MattiasVLar/AmpouleIntelligente/EDA/3DEL_MCPCB/DEL_MCPCB/DEL_MCPCB.step

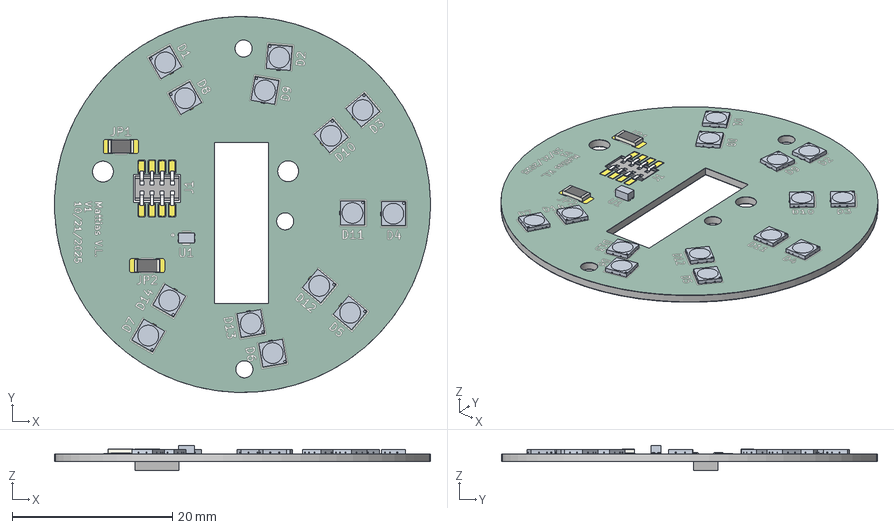
[picture p1: CAD file, 2025-12-03]
EDA/3DEL_MCPCB/DEL_MCPCB/DEL_MCPCB.step
47.0 x 47.0 x 3.16 mm
CLP-104-2-L-DTRM
C-106-22-1-L-04_Pin x 2
3030-14-H1 EMC UNIT SIZE x 14
3030-14-H1 LF UNIT SZIE x 14
ӫ¹⽺ x 14
R_1206_3216Metric x 2
80216oplga4l
DEL_MCPCB_copper
DEL_MCPCB_silkscreen
DEL_MCPCB_soldermask
DEL_MCPCB_PCB
