MattiasVLar/AmpouleIntelligente/EDA/Includes/3D/FTSH-104-01-L-DH.step

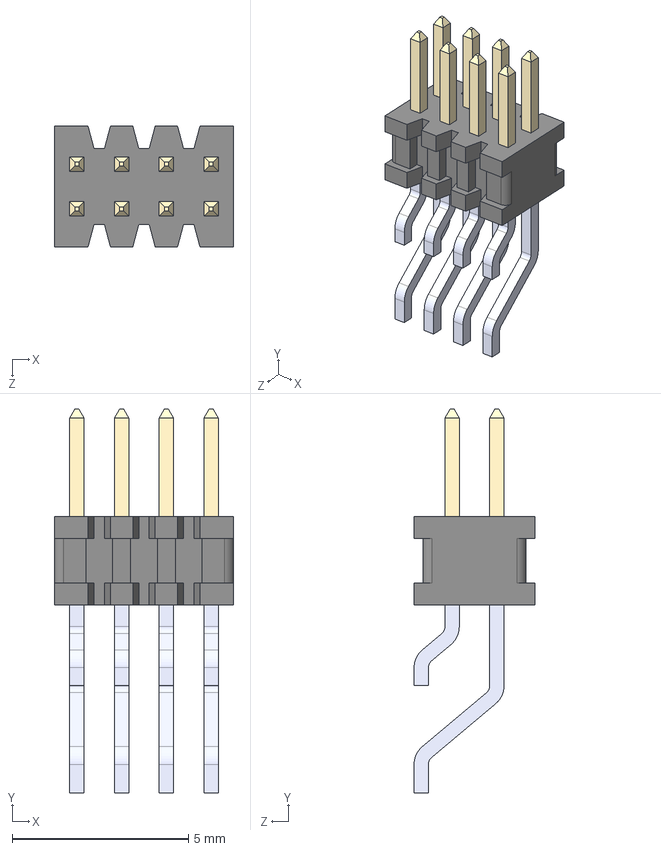
[picture p2: CAD file, 2025-12-03]
EDA/Includes/3D/FTSH-104-01-L-DH.step
5.08 x 10.9 x 3.43 mm
