MattiasVLar/AmpouleIntelligente/EDA/Includes/Downloads/1N5819HW_7_F/1N5819HW-7-F.step

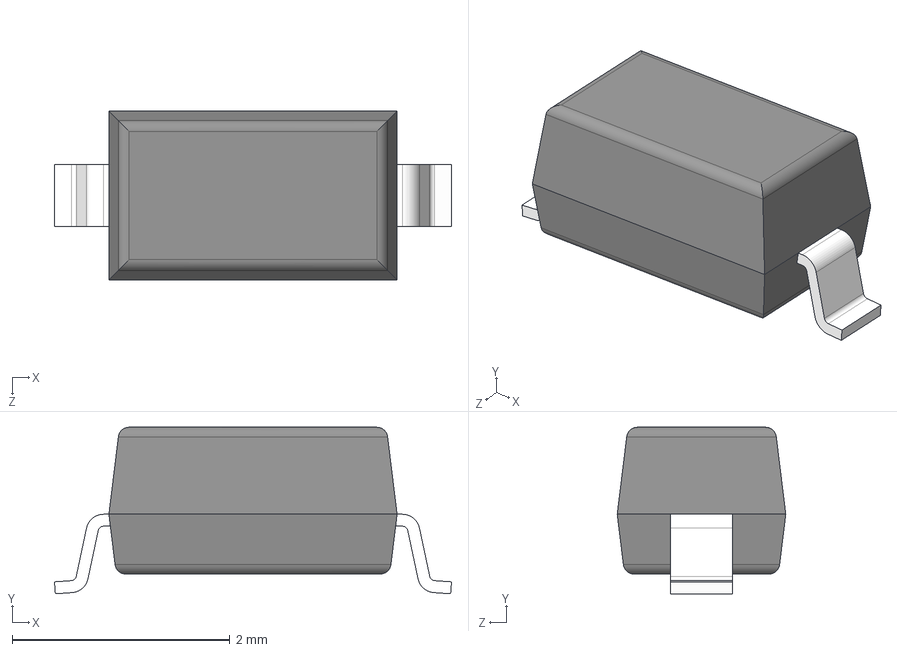
[picture p3: CAD file, 2025-12-03]
EDA/Includes/Downloads/1N5819HW_7_F/1N5819HW-7-F.step
3.65 x 1.53 x 1.55 mm
