MattiasVLar/AmpouleIntelligente/EDA/Includes/Downloads/35ZLH470MEFC10X16/CAP_YX_10X16_RUB.step

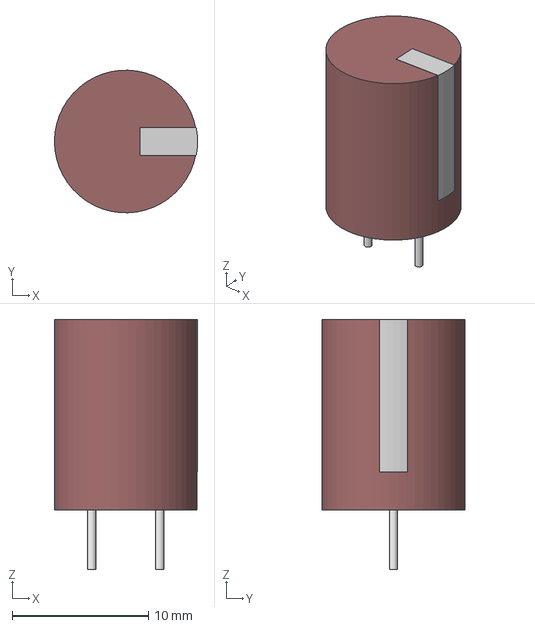
[picture p4: CAD file, 2025-12-03]
EDA/Includes/Downloads/35ZLH470MEFC10X16/CAP_YX_10X16_RUB.step
10.5 x 10.5 x 18.4 mm
