MattiasVLar/AmpouleIntelligente/EDA/Includes/Downloads/400AX15MEFC10X16/CAP_AX_10X16_RUB.step

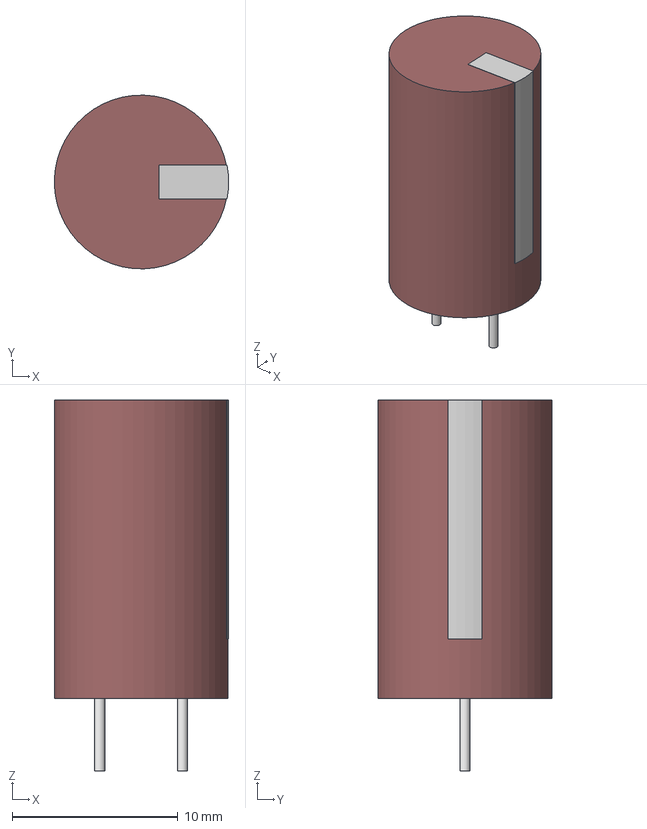
[picture p5: CAD file, 2025-12-03]
EDA/Includes/Downloads/400AX15MEFC10X16/CAP_AX_10X16_RUB.step
10.5 x 10.5 x 22.4 mm
