MattiasVLar/AmpouleIntelligente/EDA/Includes/Downloads/450BXW15MEFR10X20/450BXW15MEFR10X20.step

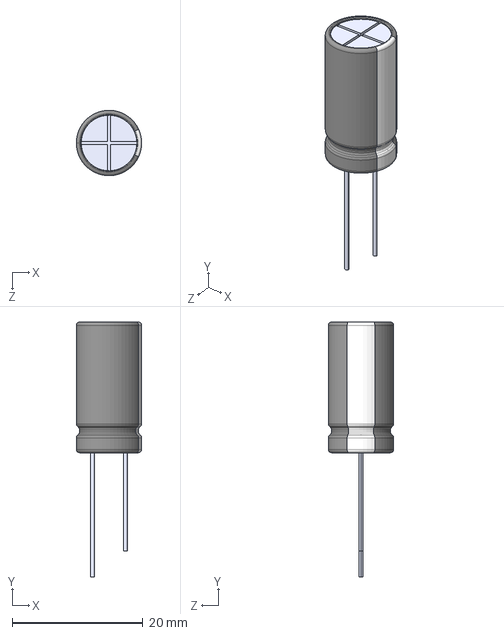
[picture p6: CAD file, 2025-12-03]
EDA/Includes/Downloads/450BXW15MEFR10X20/450BXW15MEFR10X20.step
10.00 x 39.0 x 10.00 mm
