MattiasVLar/AmpouleIntelligente/EDA/Includes/Downloads/450QXW22MEFR8X45/CAP_C_8X45_RUB.step

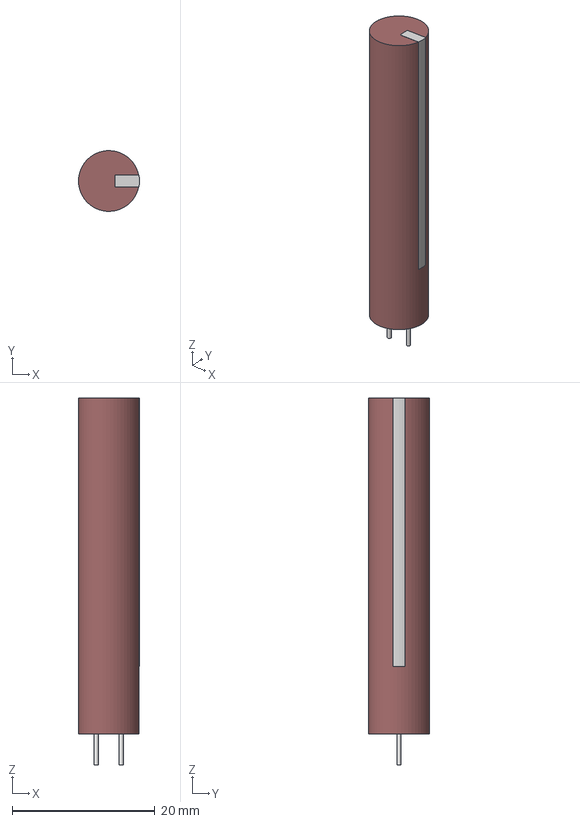
[picture p7: CAD file, 2025-12-03]
EDA/Includes/Downloads/450QXW22MEFR8X45/CAP_C_8X45_RUB.step
8.54 x 8.50 x 51.4 mm
