MattiasVLar/AmpouleIntelligente/EDA/Includes/Downloads/61300211121/6130XX11121_61300211121.step

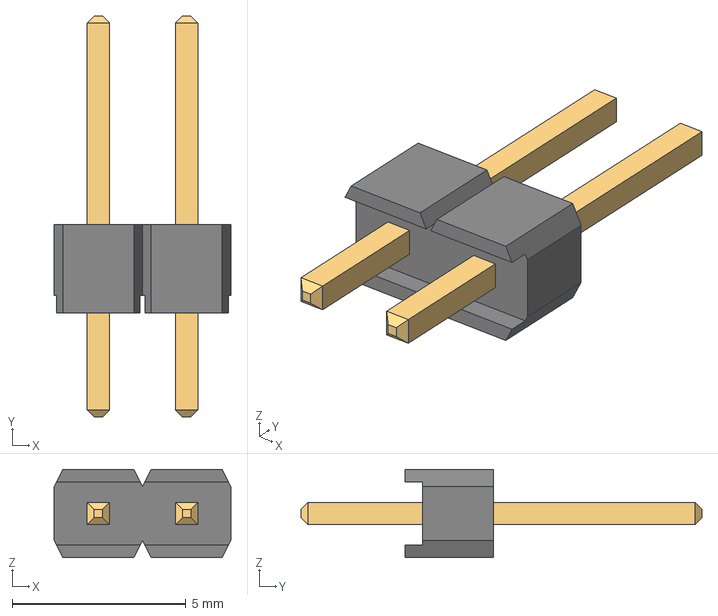
[picture p8: CAD file, 2025-12-03]
EDA/Includes/Downloads/61300211121/6130XX11121_61300211121.step
5.08 x 11.5 x 2.54 mm
6130xx11121_PIN x 2
