MattiasVLar/AmpouleIntelligente/EDA/Includes/Downloads/744025330/WE-TPC_2828.step

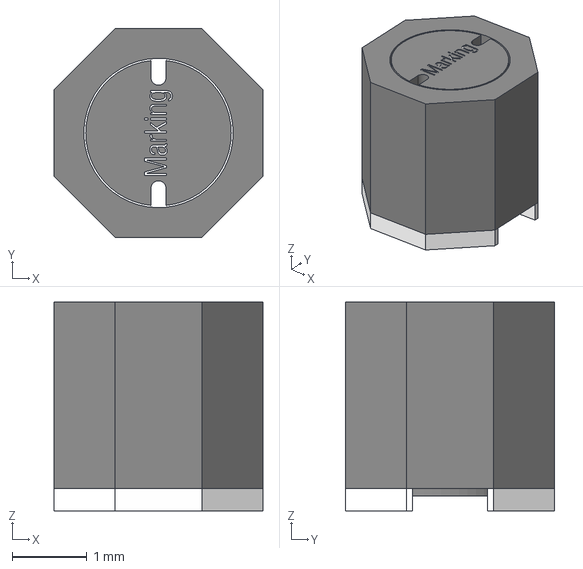
[picture p9: CAD file, 2025-12-03]
EDA/Includes/Downloads/744025330/WE-TPC_2828.step
2.80 x 2.80 x 2.80 mm
