MattiasVLar/AmpouleIntelligente/EDA/Includes/Downloads/860040573004/WCAP-ATUL_6.3X11.step

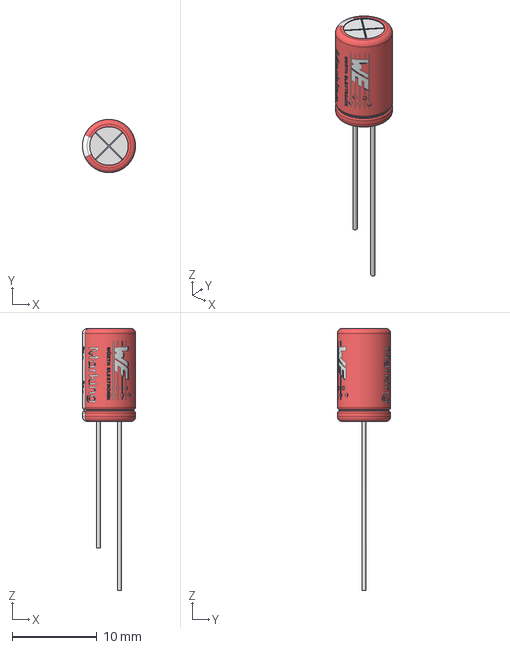
[picture p10: CAD file, 2025-12-03]
EDA/Includes/Downloads/860040573004/WCAP-ATUL_6.3X11.step
6.29 x 6.30 x 31.0 mm
