MattiasVLar/AmpouleIntelligente/EDA/Includes/Downloads/BCR421UFDQ_7/BCR421UFDQ-7.step

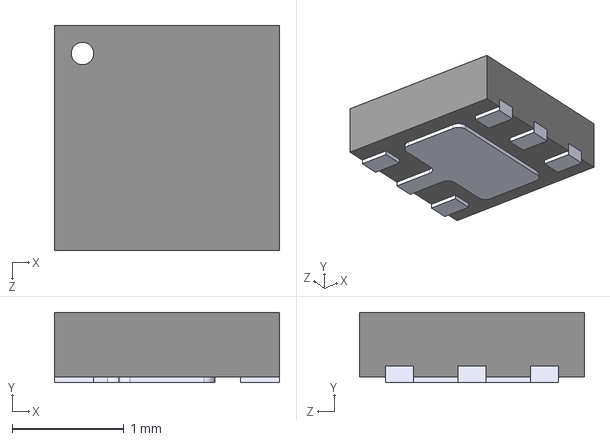
[picture p11: CAD file, 2025-12-03]
EDA/Includes/Downloads/BCR421UFDQ_7/BCR421UFDQ-7.step
2.01 x 0.63 x 2.01 mm
