MattiasVLar/AmpouleIntelligente/EDA/Includes/Downloads/CLP_104_02_L_D/CON8_2X4_DUA_CLP_SAI.step

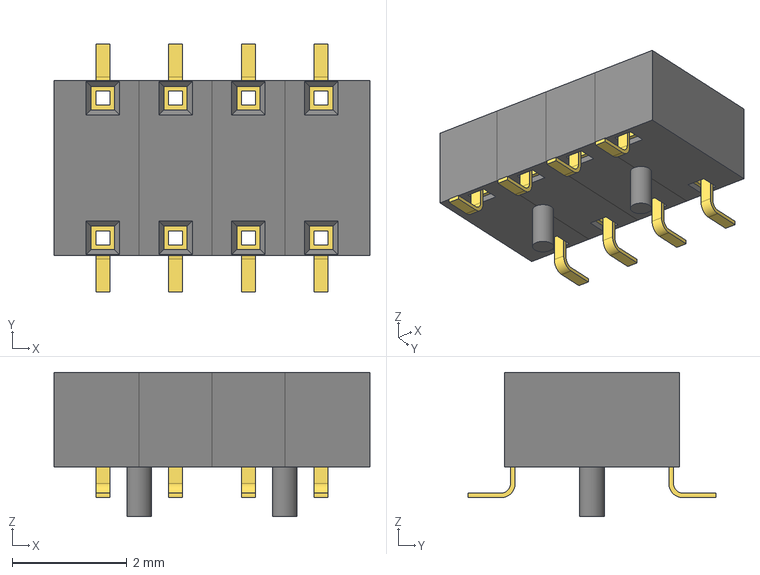
[picture p12: CAD file, 2025-12-03]
EDA/Includes/Downloads/CLP_104_02_L_D/CON8_2X4_DUA_CLP_SAI.step
5.51 x 4.32 x 2.51 mm
