MattiasVLar/AmpouleIntelligente/EDA/Includes/Downloads/ESP32_C6_MINI_1_N4/ESP32-C6-MINI-1-N4.step

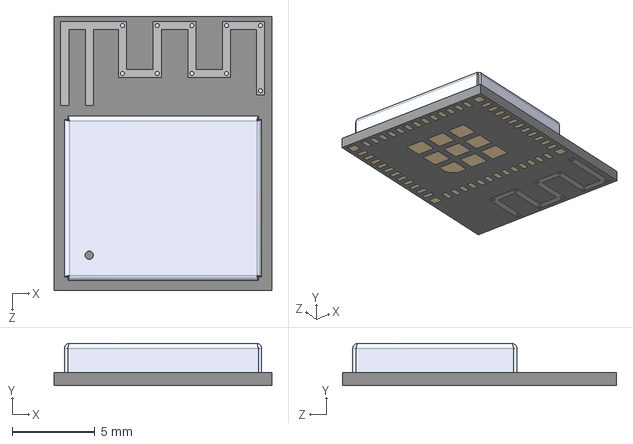
[picture p13: CAD file, 2025-12-03]
EDA/Includes/Downloads/ESP32_C6_MINI_1_N4/ESP32-C6-MINI-1-N4.step
13.2 x 2.55 x 16.6 mm
