MattiasVLar/AmpouleIntelligente/EDA/Includes/Downloads/FTSH_103_04_L_DH/FTSH-103-04-L-DH.step

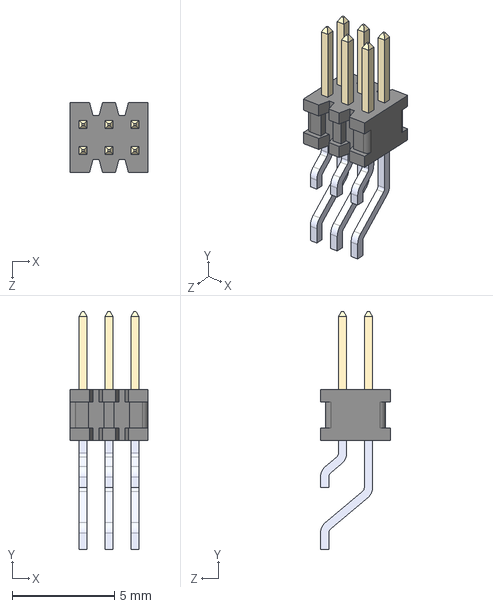
[picture p14: CAD file, 2025-12-03]
EDA/Includes/Downloads/FTSH_103_04_L_DH/FTSH-103-04-L-DH.step
3.81 x 11.7 x 3.43 mm
