MattiasVLar/AmpouleIntelligente/EDA/Includes/Downloads/MAMK2520T4R7M/IND_MAMK2520T1R0M_TAY.step

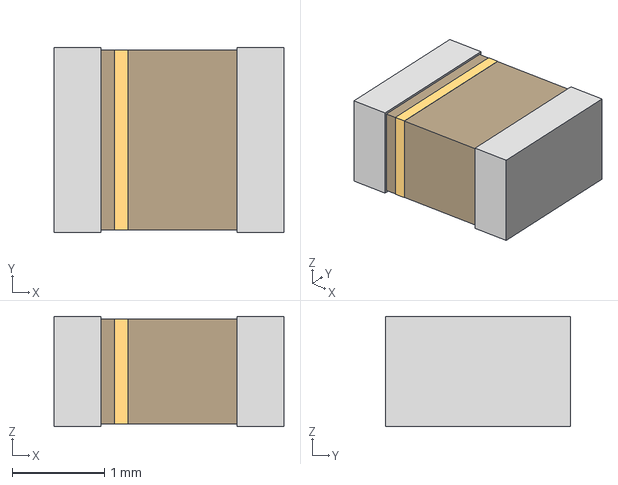
[picture p15: CAD file, 2025-12-03]
EDA/Includes/Downloads/MAMK2520T4R7M/IND_MAMK2520T1R0M_TAY.step
2.49 x 2.01 x 1.19 mm
