MattiasVLar/AmpouleIntelligente/EDA/Includes/Downloads/SRN4018_2R2M/IND_BOURNS_SRN4018.step

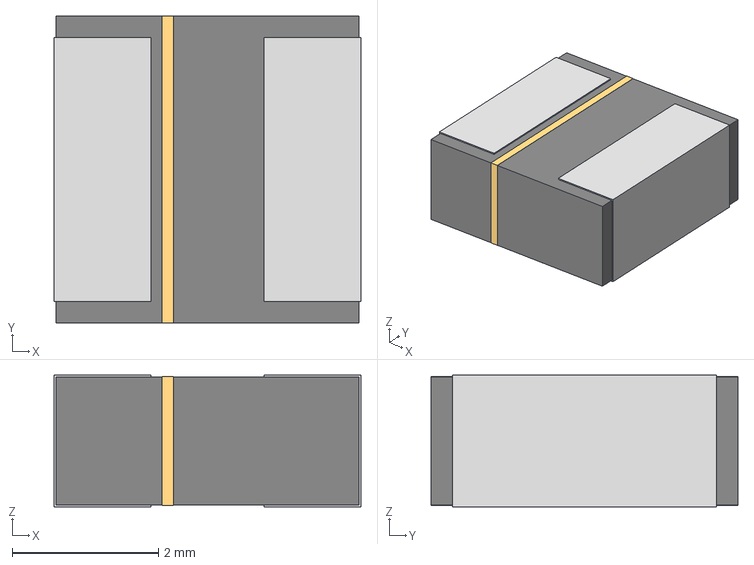
[picture p16: CAD file, 2025-12-03]
EDA/Includes/Downloads/SRN4018_2R2M/IND_BOURNS_SRN4018.step
4.19 x 4.20 x 1.80 mm
