MattiasVLar/AmpouleIntelligente/EDA/Includes/Downloads/SRR1208_222KL/IND_BOURNS_SRR1208.step

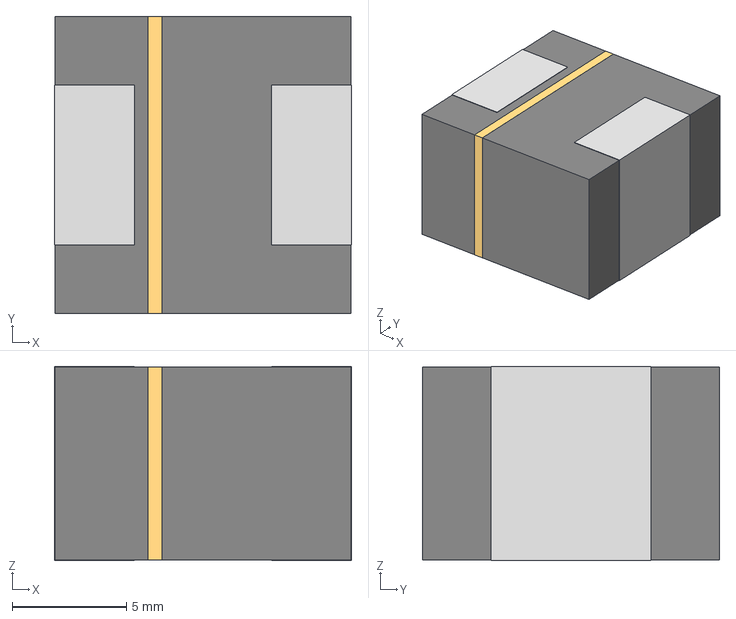
[picture p17: CAD file, 2025-12-03]
EDA/Includes/Downloads/SRR1208_222KL/IND_BOURNS_SRR1208.step
13.0 x 13.0 x 8.51 mm
