MattiasVLar/AmpouleIntelligente/EDA/Includes/Downloads/UCS2W220MHD/PCAP_16x20-THRU-ELECT_NCA.step

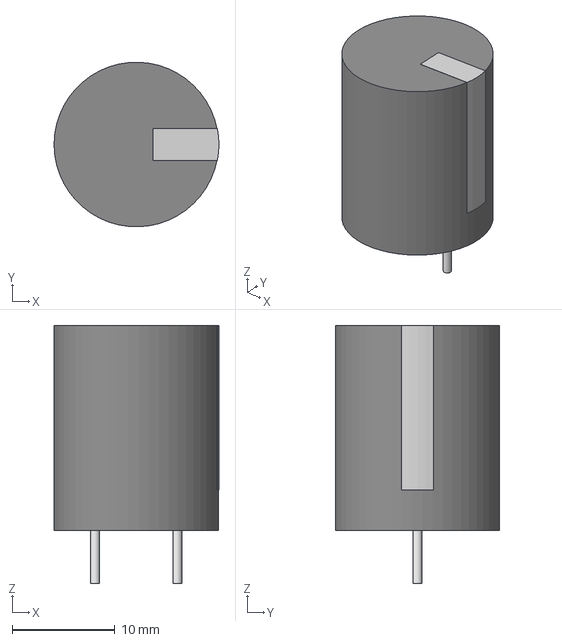
[picture p18: CAD file, 2025-12-03]
EDA/Includes/Downloads/UCS2W220MHD/PCAP_16x20-THRU-ELECT_NCA.step
16.0 x 16.0 x 25.1 mm
