MattiasVLar/AmpouleIntelligente/EDA/Includes/Downloads/UCV1V471MNL1GS/CAP_UCD_8X10_NCH.step

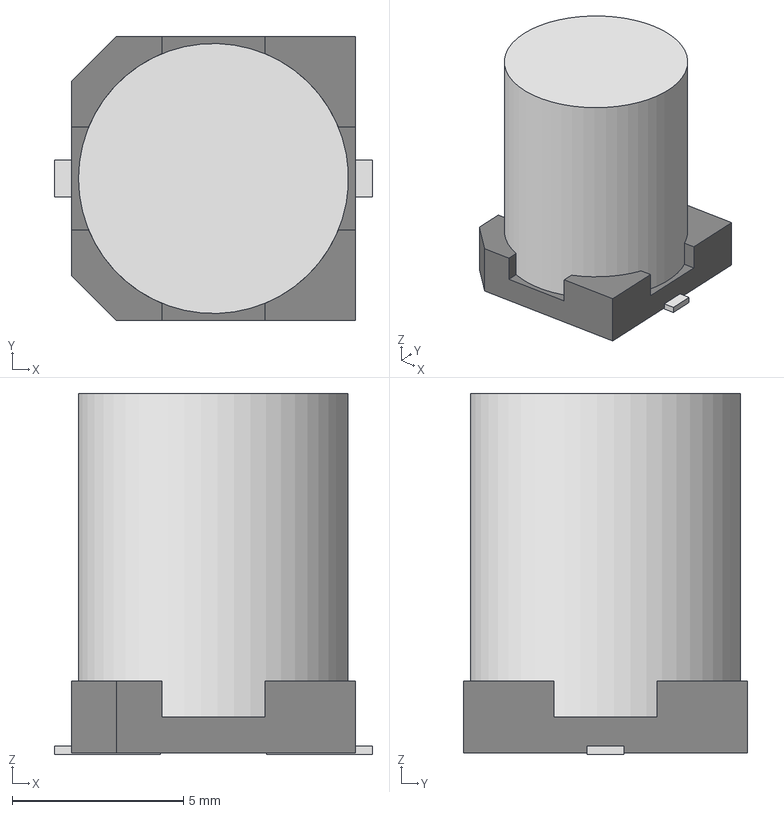
[picture p19: CAD file, 2025-12-03]
EDA/Includes/Downloads/UCV1V471MNL1GS/CAP_UCD_8X10_NCH.step
9.30 x 8.31 x 10.5 mm
