MattiasVLar/AmpouleIntelligente/EDA/Includes/Downloads/USB4515_GF_A/USB4515-GF-A.STEP

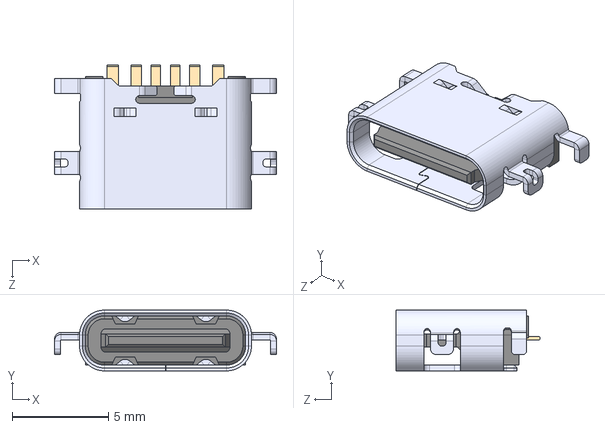
[picture p20: CAD file, 2025-12-03]
EDA/Includes/Downloads/USB4515_GF_A/USB4515-GF-A.STEP
11.5 x 3.16 x 7.50 mm
