MattiasVLar/AmpouleIntelligente/EDA/Includes/Downloads/UVC2G100MPD1TD/CAP_UBT_10X12P5_NCH.step

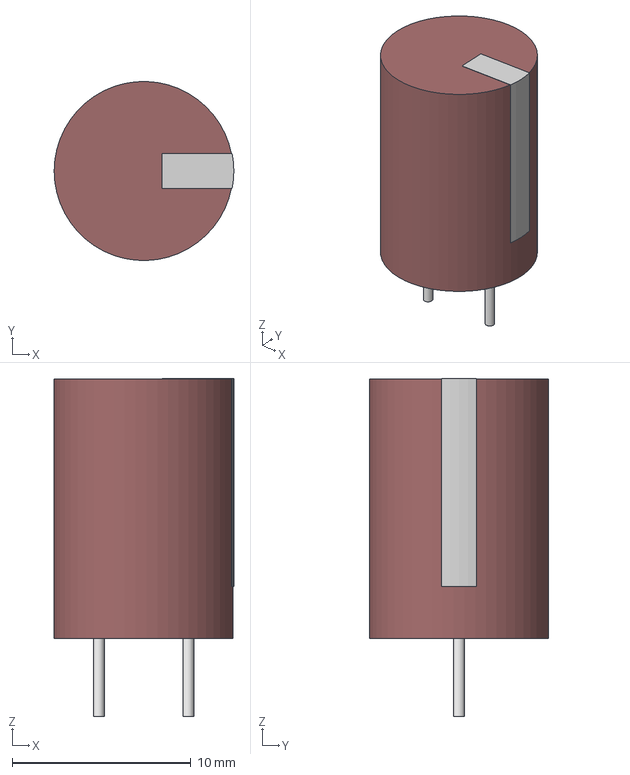
[picture p21: CAD file, 2025-12-03]
EDA/Includes/Downloads/UVC2G100MPD1TD/CAP_UBT_10X12P5_NCH.step
10.0 x 10.0 x 18.9 mm
