MattiasVLar/AmpouleIntelligente/EDA/Includes/3D/J Series 3030 Round.STEP

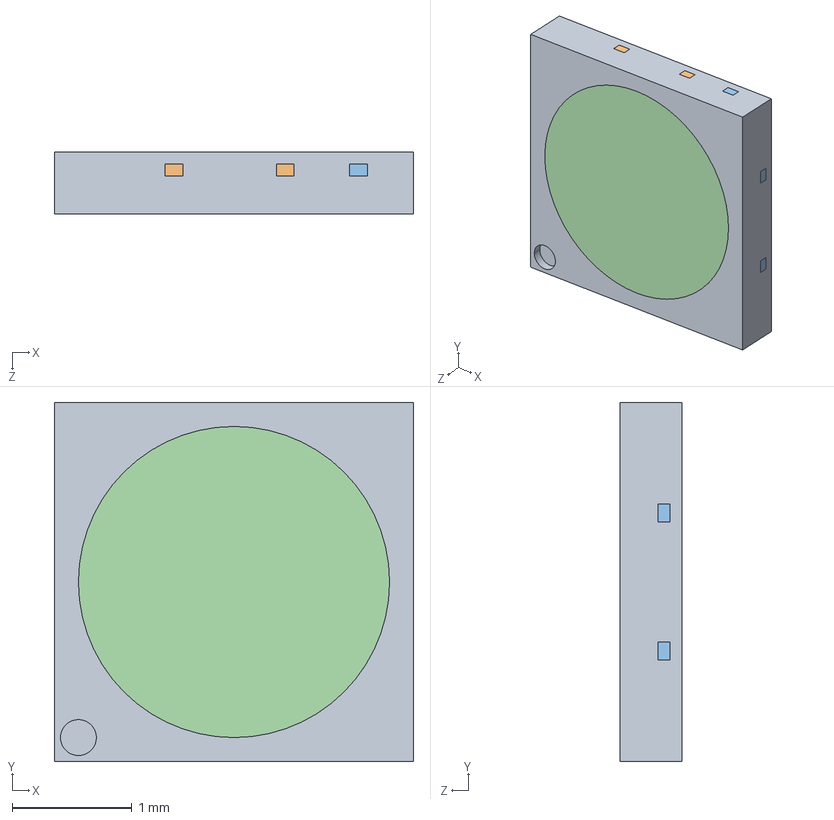
[picture p22: CAD file, 2025-12-03]
EDA/Includes/3D/J Series 3030 Round.STEP
3.00 x 3.00 x 0.52 mm
3030-14-H1 EMC UNIT SIZE
3030-14-H1 LF UNIT SZIE
茷嫖蝶
