MattiasVLar/AmpouleIntelligente/EDA/Includes/3D/B3U-1000P.step

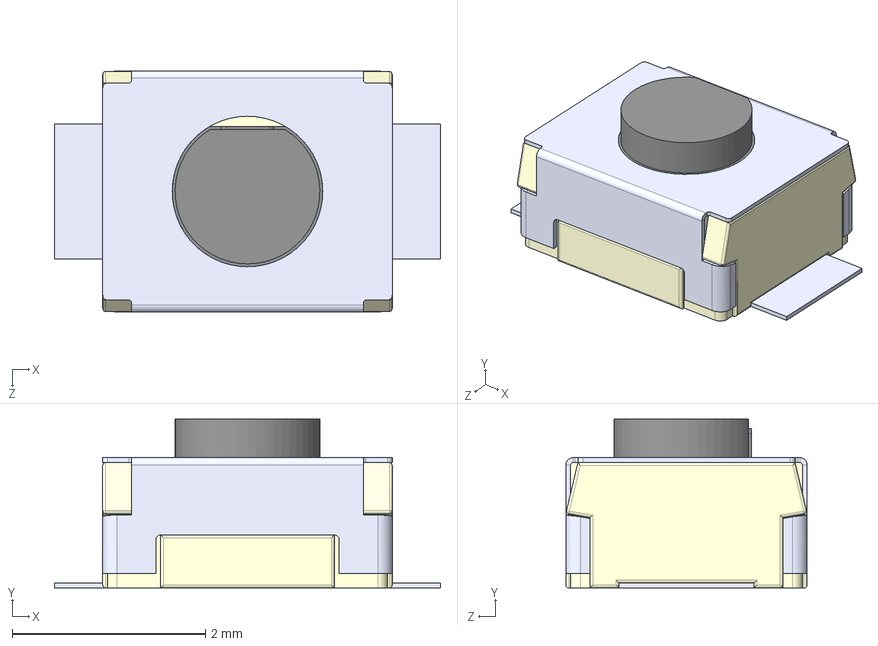
[picture p23: CAD file, 2025-12-03]
EDA/Includes/3D/B3U-1000P.step
4.00 x 1.75 x 2.50 mm
