MattiasVLar/AmpouleIntelligente/EDA/Includes/3D/usb4220-03-1000-c.stp

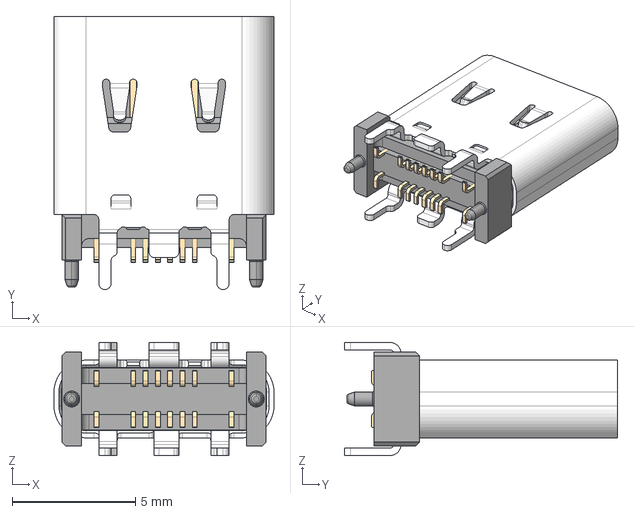
[picture p24: CAD file, 2025-12-03]
EDA/Includes/3D/usb4220-03-1000-c.stp
8.94 x 11.1 x 4.60 mm
