MattiasVLar/AmpouleIntelligente/EDA/Includes/3D/RES_NKN3WS_15P5X5_YAG.step

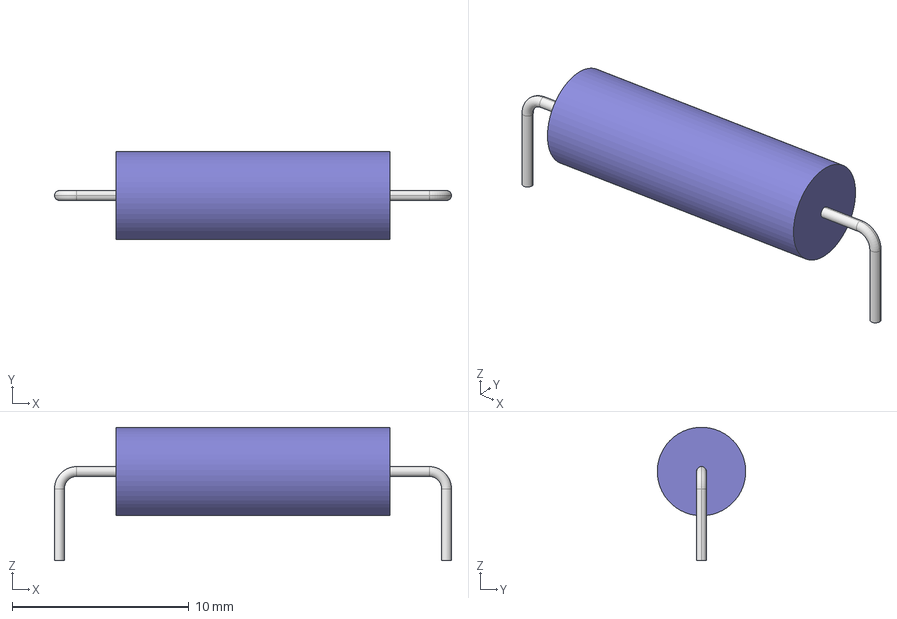
[picture p25: CAD file, 2025-12-03]
EDA/Includes/3D/RES_NKN3WS_15P5X5_YAG.step
22.5 x 5.00 x 7.54 mm
