MattiasVLar/AmpouleIntelligente/EDA/Includes/3D/c-1825910-6-c-3d.stp

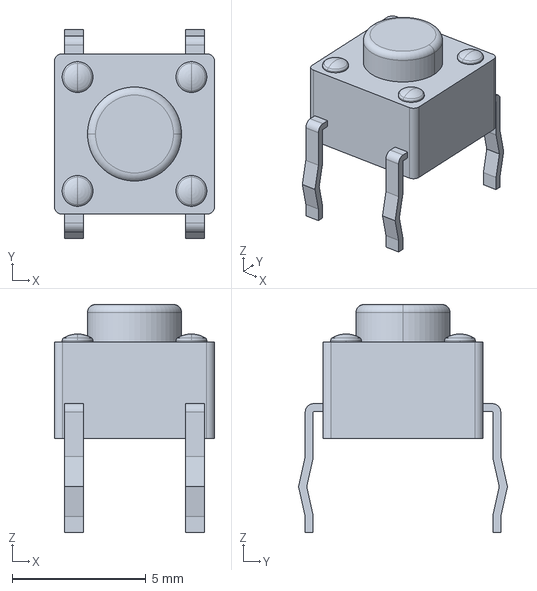
[picture p26: CAD file, 2025-12-03]
EDA/Includes/3D/c-1825910-6-c-3d.stp
5.99 x 7.80 x 8.51 mm
