MattiasVLar/AmpouleIntelligente/EDA/Includes/3D/CLP-104-02-X-D.step

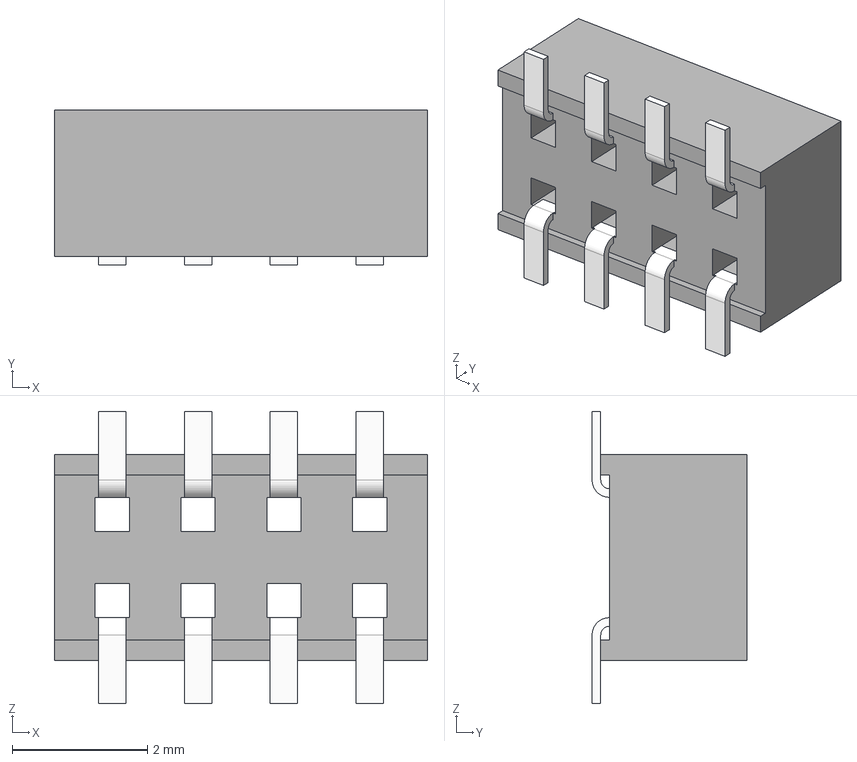
[picture p27: CAD file, 2025-12-03]
EDA/Includes/3D/CLP-104-02-X-D.step
5.51 x 2.29 x 4.32 mm
CLP-104-2-L-DTRM
C-106-22-1-L-04_Pin x 2
