MattiasVLar/AmpouleIntelligente/EDA/Includes/3D/SDO_SOD123_DIO.step

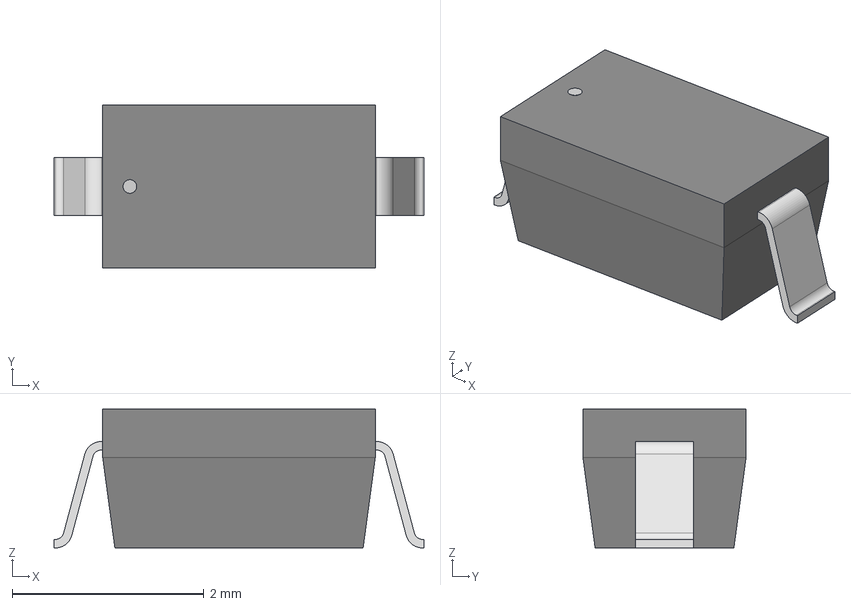
[picture p28: CAD file, 2025-12-03]
EDA/Includes/3D/SDO_SOD123_DIO.step
3.86 x 1.70 x 1.45 mm
