MattiasVLar/AmpouleIntelligente/EDA/Includes/3D/DO-41_STM.step

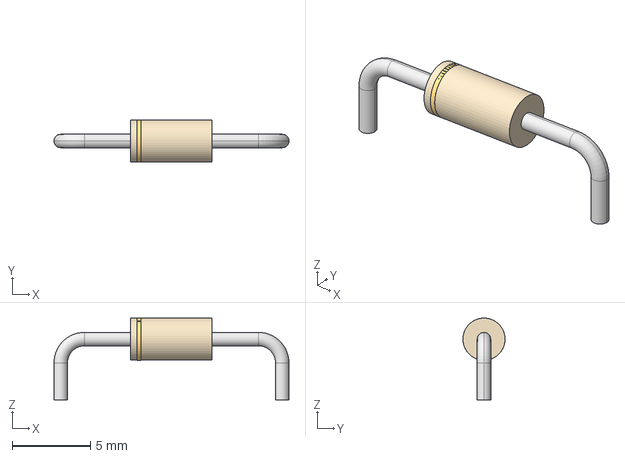
[picture p29: CAD file, 2025-12-03]
EDA/Includes/3D/DO-41_STM.step
15.0 x 2.70 x 5.23 mm
