MattiasVLar/AmpouleIntelligente/EDA/Includes/3D/USB4520-03-0-A_REVA.step

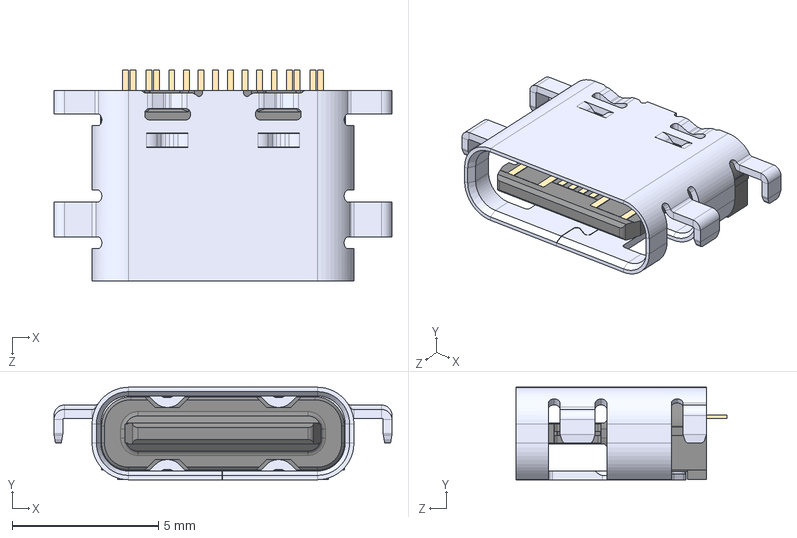
[picture p30: CAD file, 2025-12-03]
EDA/Includes/3D/USB4520-03-0-A_REVA.step
11.5 x 3.16 x 7.20 mm
