MattiasVLar/AmpouleIntelligente/(list of files, cad)

Other CAD files:
EDA/Includes/Downloads/74438336047HT/WE-MAPI_3020HT.step
EDA/Includes/3D/36911000000.STEP
EDA/Includes/3D/80216oplga4l.stp
EDA/Includes/Downloads/36911000000 (1)/36911000000.step
EDA/Includes/Downloads/36911000000 (2)/36911000000.STEP
EDA/Includes/Downloads/450BXW15MEFR10X20 (2)/CAP_BX_10x20_RUB.step
EDA/Includes/Downloads/TPS560430XFDBVR/TPS560430XFDBVR.step
EDA/Includes/Downloads/TPS92200D2DDCR (1)/DDC0006A.stp
EDA/Includes/Downloads/USB4220_03_1000_C (1)/usb4220-03-1000-c.stp
EDA/Includes/Downloads/VEML3328/80216oplga4l.stp
