MattiasVLar/AmpouleIntelligente/EDA/2ESP32_PCB/DOC/esp32-c6-devkitm-1-schematics.pdf

# System Block:

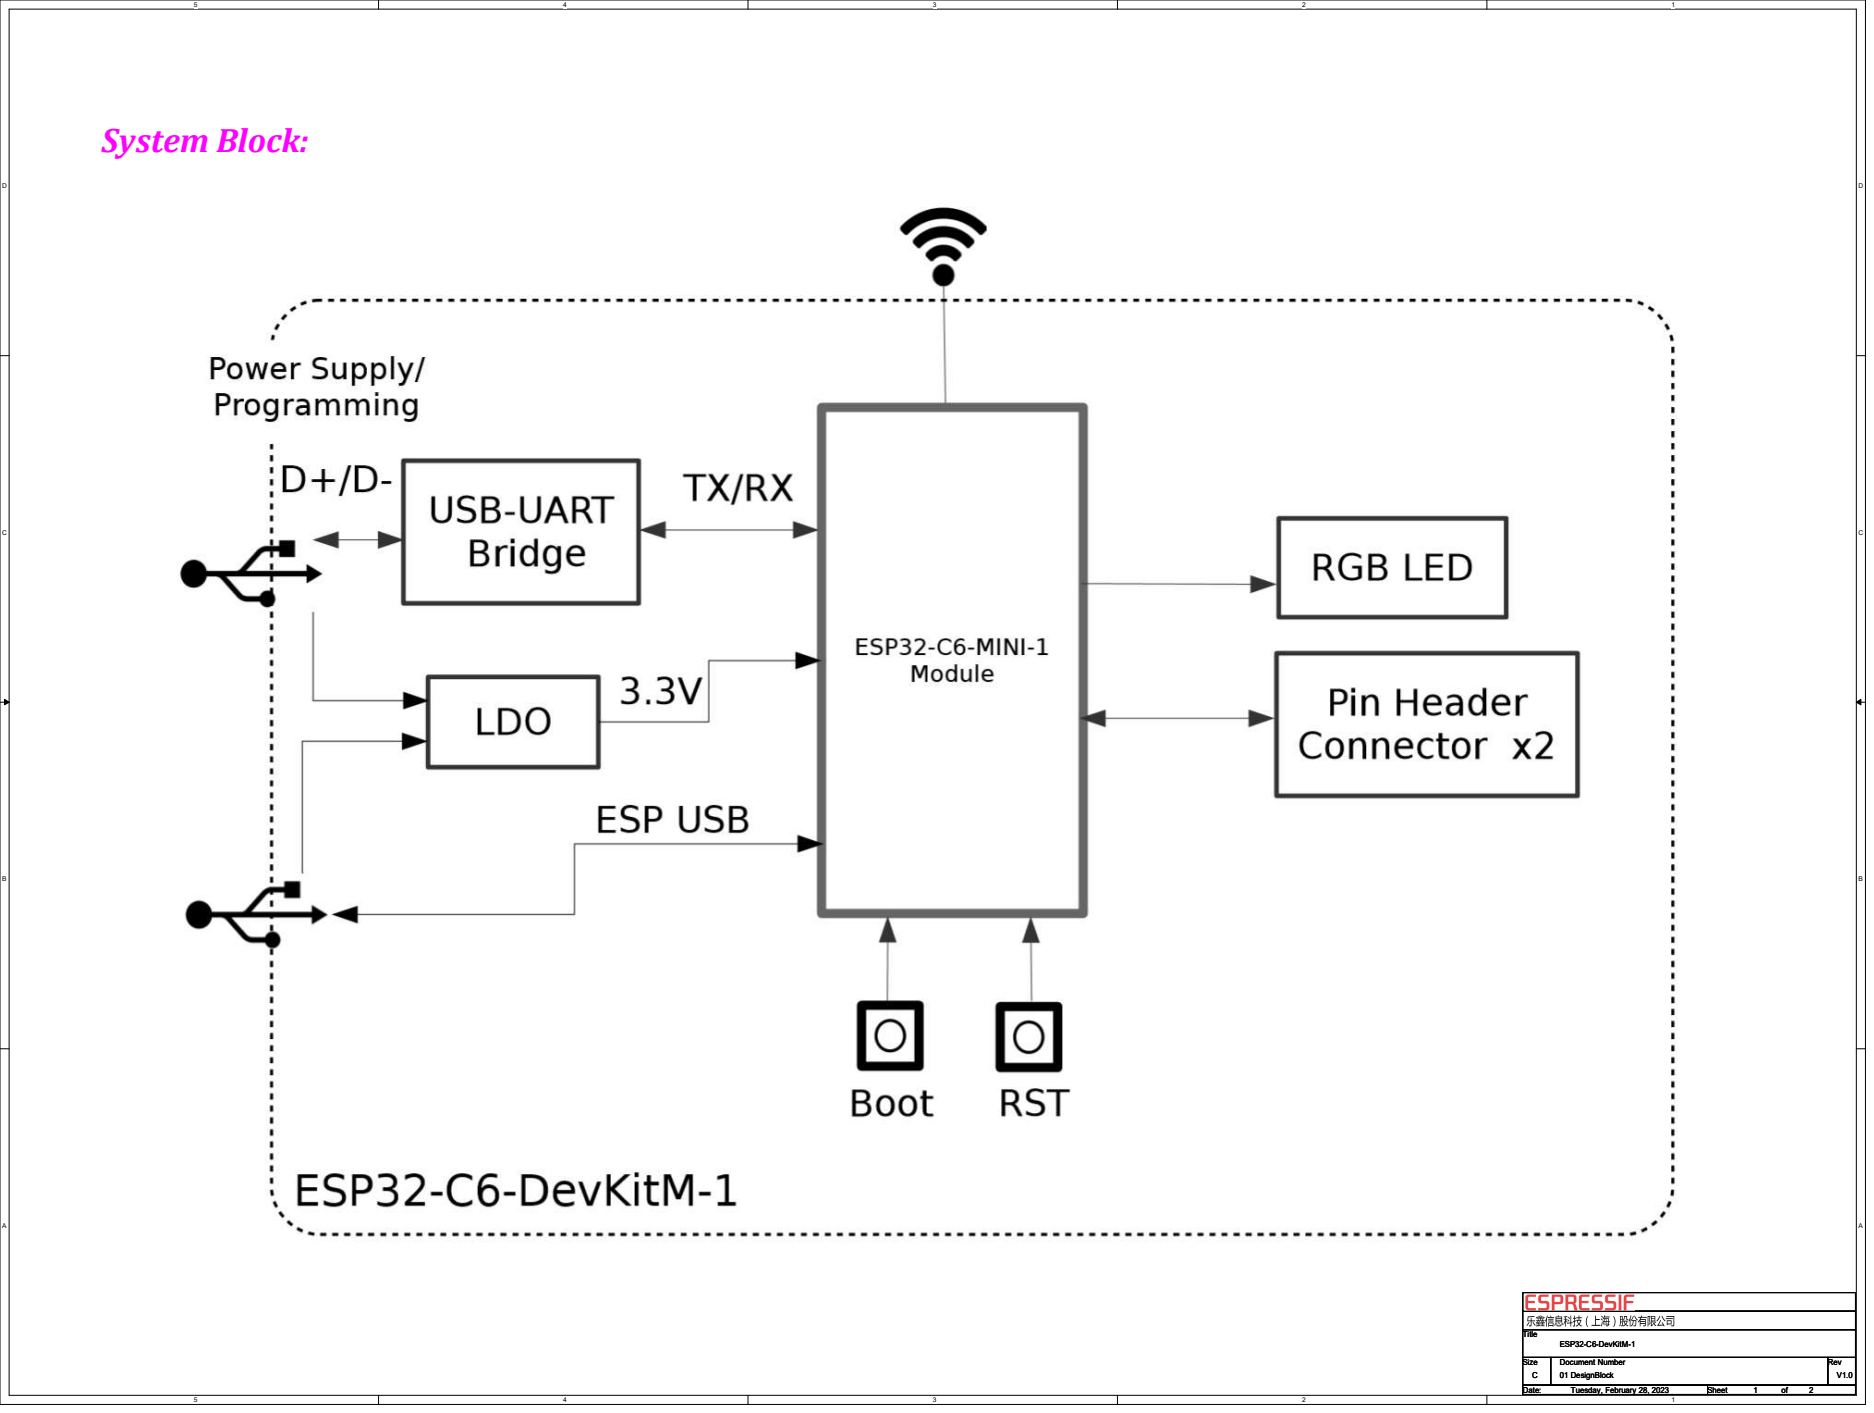
[picture p36: page 1]
Title Size; Document Number; Rev Date:; Sheet; of 01 DesignBlock; V1.0 ESP32-C6-DevKitM-1 C; Tuesday, February 28, 2023; 2 Title Size

ESP32-C6-MINI-1: | Pin Header:

# USB to UART:

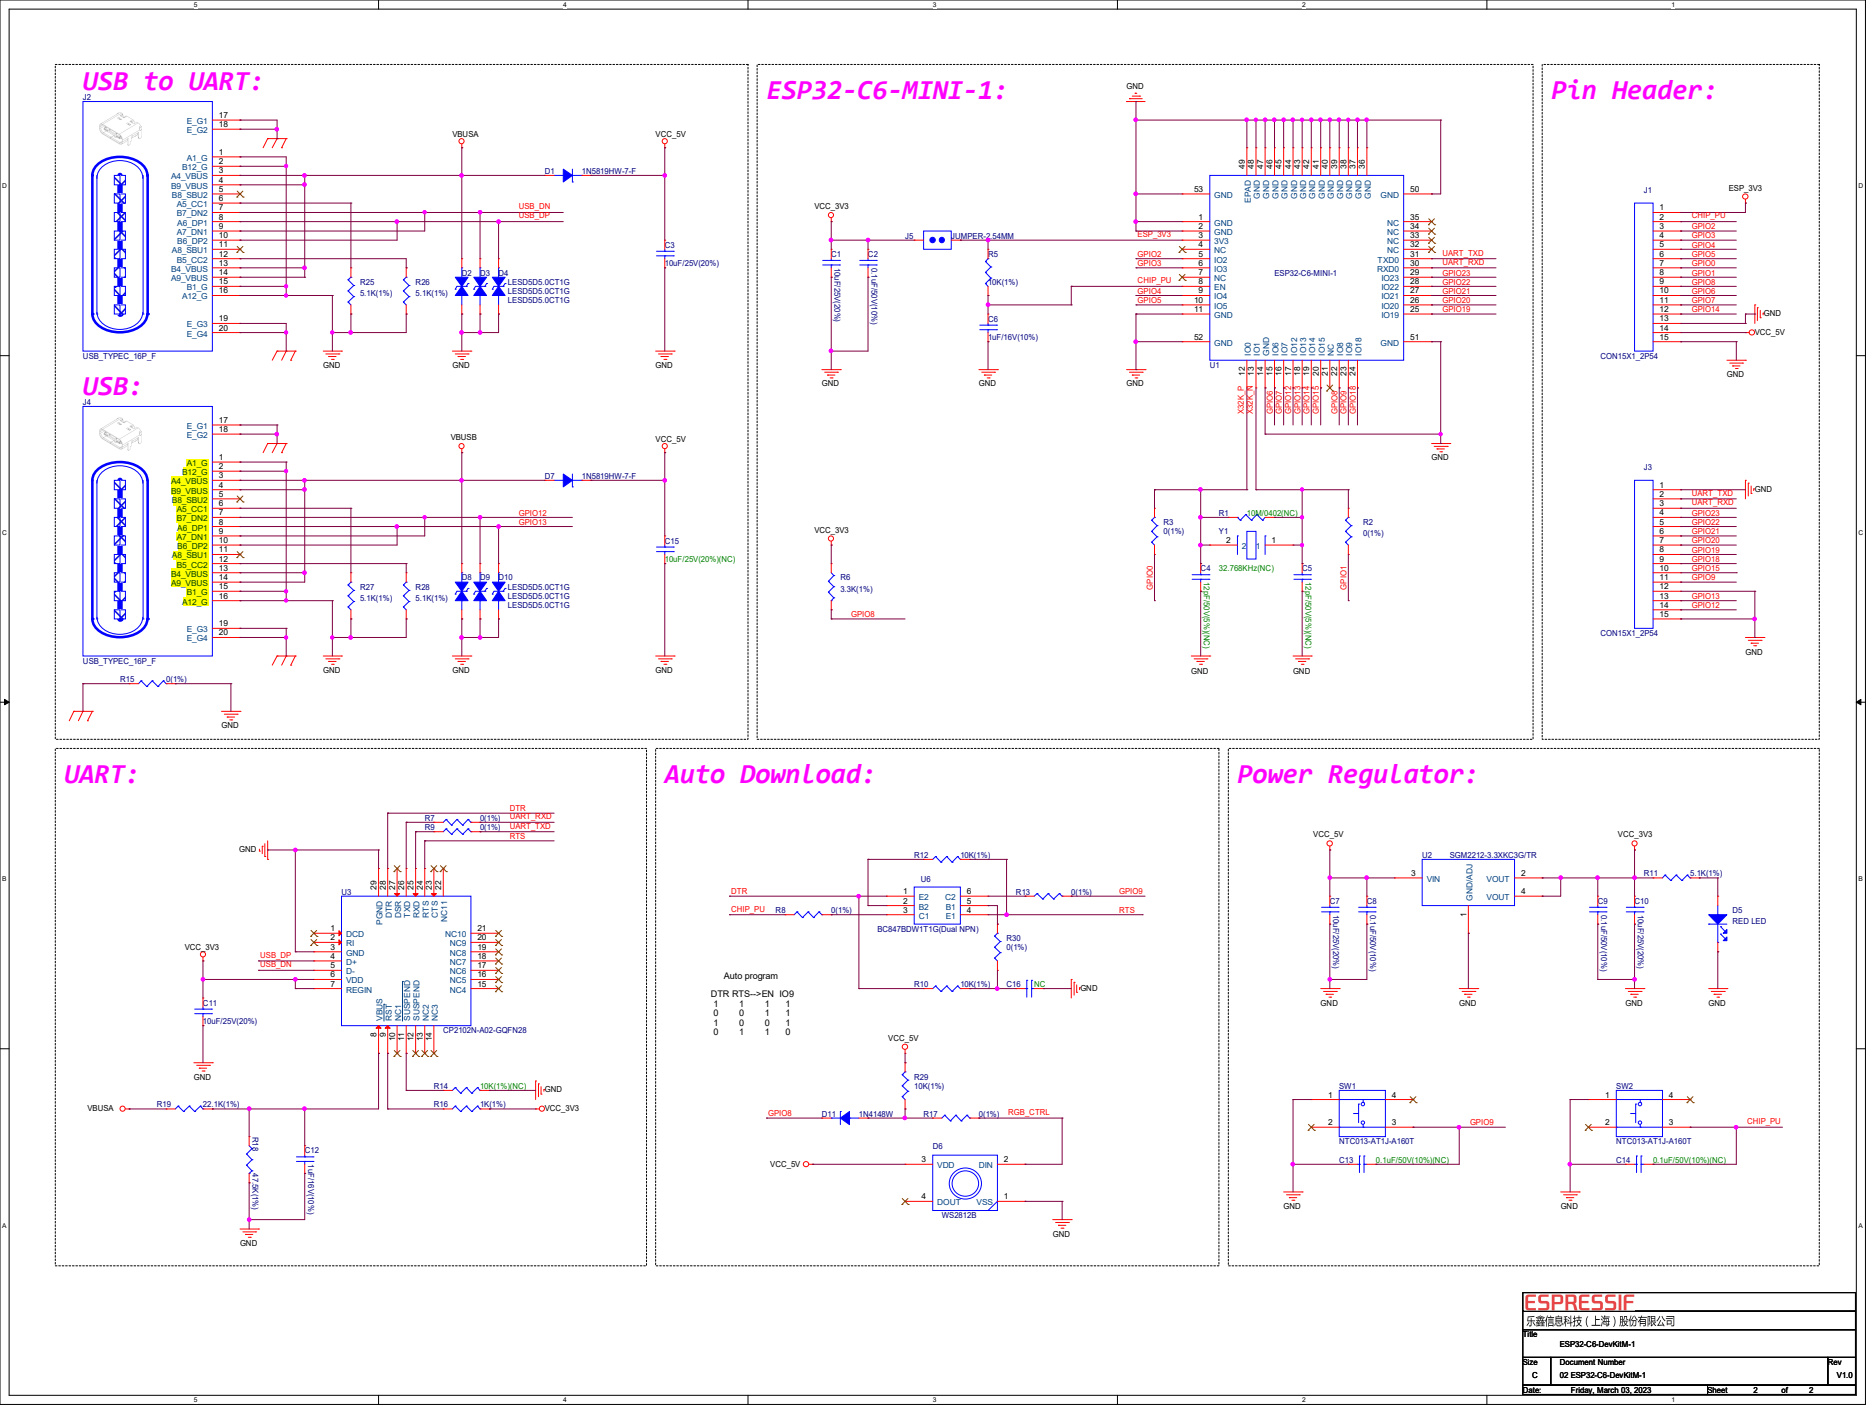
[picture p37: page 2]

9 NC1 10 SUSPEND 11 SUSPEND 12 NC2 13 NC3 14 NC4 15 NC5 16 NC6 17 NC7 18 NC8 19 NC9 20 NC10 21 NC11 22 CTS 23 RTS 24 RXD 25 TXD 26 DSR 27 DTR 28 PGND 29 C3
