MattiasVLar/AmpouleIntelligente/EDA/1POWER_PCB/PowerPCB/plots/PowerPCB__Assembly.pdf

J6 1 | 2 | 3 | 4 | 5 | 6

A

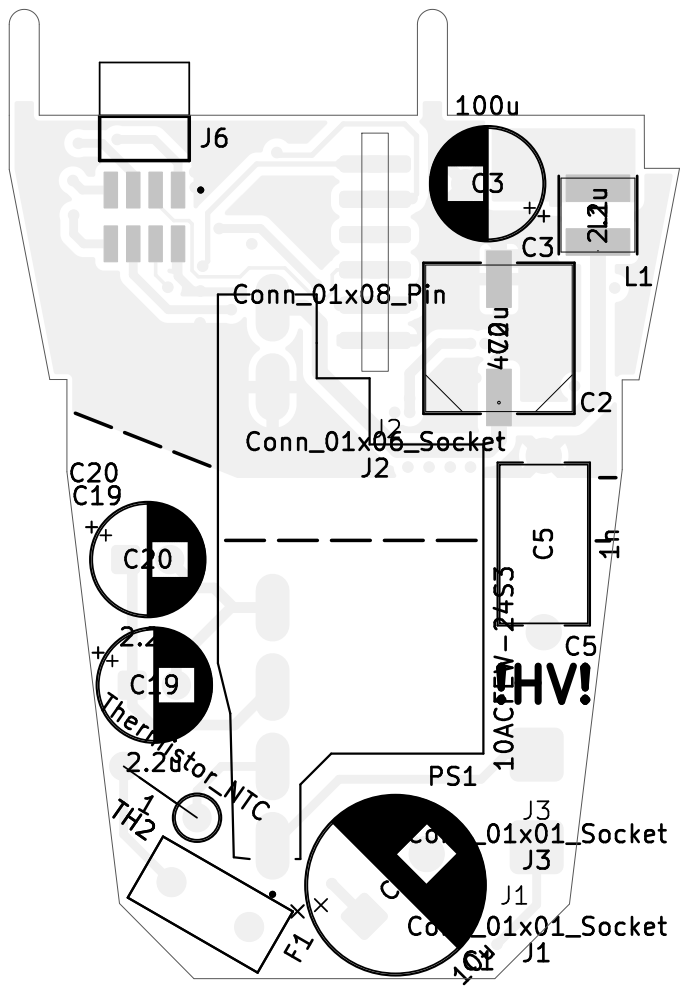
[picture p38: page 1]

1 | 2 | 3 | 4 | 5 | 6

A

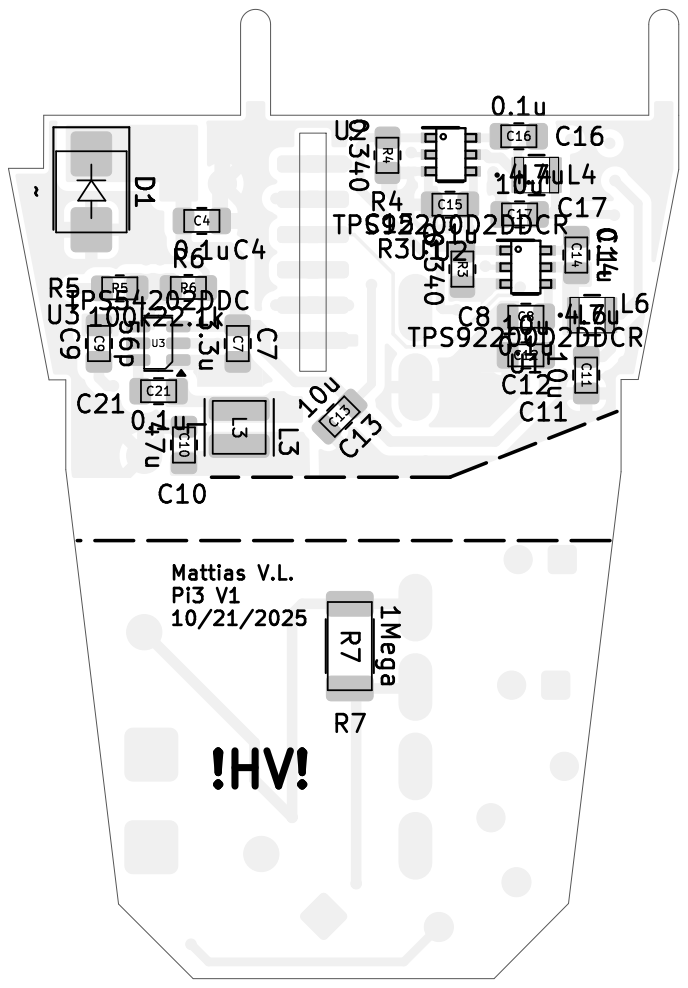
[picture p39: page 2]
