MattiasVLar/AmpouleIntelligente/EDA/2ESP32_PCB/ESP32_PCB/ESP32_PCB.kicad_pcb

## KiCad design EDA/2ESP32_PCB/ESP32_PCB/ESP32_PCB.kicad_pcb (2025-12-03)

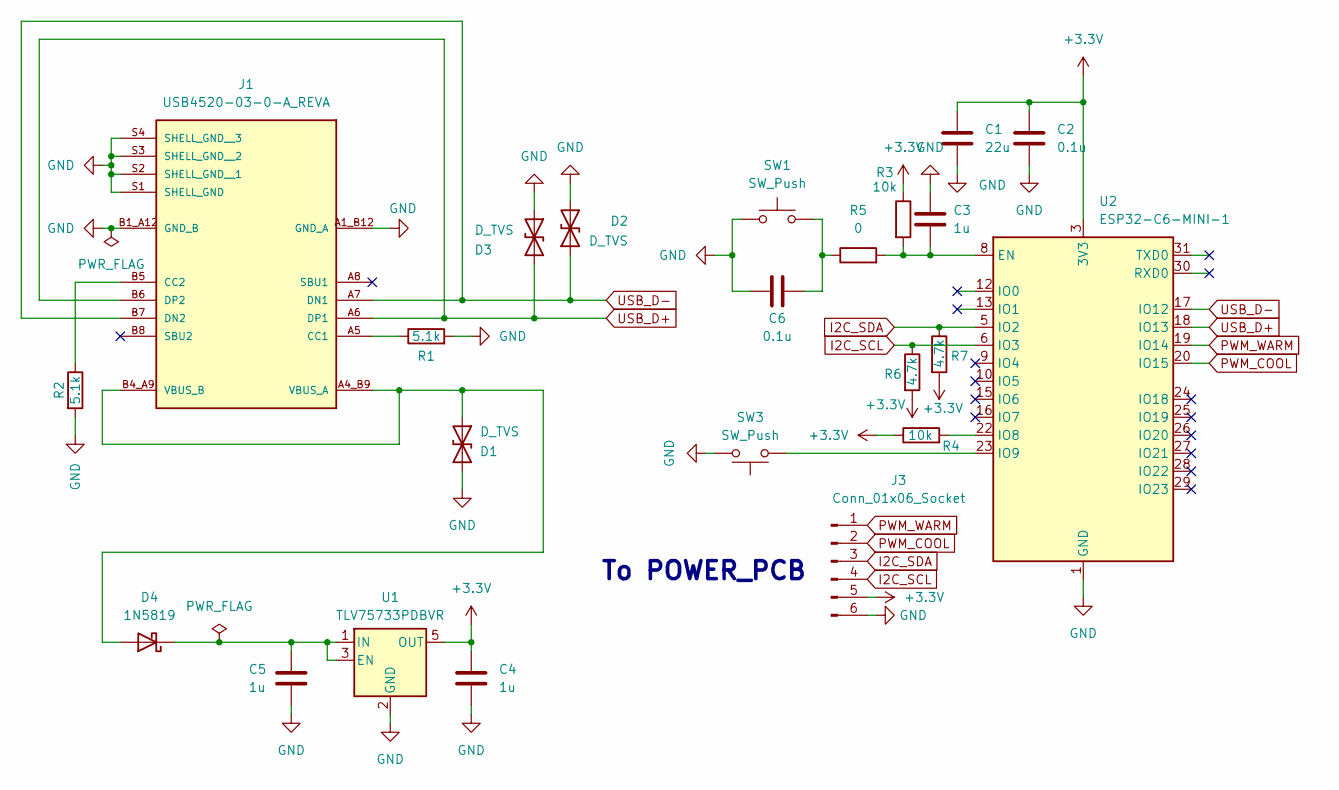
[picture p40: schematic ESP32_PCB.kicad_sch]

Parts:
C1: 22u; C_0603_1608Metric_Pad1.08x0.95mm_HandSolder; Digikey 1276-1274-1-ND
C2, C6: 0.1u; C_0603_1608Metric_Pad1.08x0.95mm_HandSolder; Digikey 311-1088-1-ND
C3, C4, C5: 1u; C_0603_1608Metric_Pad1.08x0.95mm_HandSolder; Digikey 445-CGA3E1X7R1C105K080DCCT-ND
D1: D_TVS; D_SOD-323F; Digikey 296-TSD05DYFRCT-ND
D2, D3: D_TVS; D_SOD-323F; Digikey 296-TSD05CDYFRCT-ND
D4: 1N5819; SDO_SOD123_DIO-L; Digikey B140HWDICT-ND
J1: USB4520-03-0-A_REVA; GCT_USB4520-03-0-A_REVA; PARTREV A
J3: Conn_01x06_Socket; EdgeConn
R1, R2: 5.1k; R_0603_1608Metric_Pad0.98x0.95mm_HandSolder; Digikey 311-5.10KHRCT-ND
R3, R4: 10k; R_0603_1608Metric_Pad0.98x0.95mm_HandSolder; Digikey 311-10.0KHRCT-ND
R5: 0; R_0603_1608Metric_Pad0.98x0.95mm_HandSolder; Digikey 311-0.0GRCT-ND
R6, R7: 4.7k; R_0603_1608Metric_Pad0.98x0.95mm_HandSolder; Digikey 311-4.70KHRCT-ND
SW1, SW3: SW_Push; SW_B3U-1000P; Digikey SW1020CT-ND
U1: TLV75733PDBVR; SOT-23-5; Digikey 296-50414-1-ND
U2: ESP32-C6-MINI-1; Digikey 1965-ESP32-C6-MINI-1-H4CT-ND

Connections:
+3.3V: C1.1, C2.2, C4.1, J3.5, R3.1, R4.1, R6.2, R7.2, U1.5 (OUT), U2.3 (3V3)
GND: C1.2, C2.1, C3.2, C4.2, C5.2, C6.2, D1.2 (A2), D2.2 (A2), D3.1 (A1), J1.A1_B12 (GND_A), J1.B1_A12 (GND_B), J1.S1 (SHELL_GND), J1.S2 (SHELL_GND__1), J1.S3 (SHELL_GND__2), J1.S4 (SHELL_GND__3), J3.6, R1.2, R2.2, SW1.1, SW3.2, U1.2 (GND), U2.1 (GND), U2.2 (GND), U2.11 (GND), U2.14 (GND), U2.36 (GND), U2.37 (GND), U2.38 (GND), U2.39 (GND), U2.40 (GND), U2.41 (GND), U2.42 (GND), U2.43 (GND), U2.44 (GND), U2.45 (GND), U2.46 (GND), U2.47 (GND), U2.48 (GND), U2.49 (GND), U2.50 (GND), U2.51 (GND), U2.52 (GND), U2.53 (GND)
I2C_SCL: J3.4, R6.1, U2.6 (IO3)
I2C_SDA: J3.3, R7.1, U2.5 (IO2)
unnamed: C6.1, R5.1, SW1.2
unnamed: D1.1 (A1), D4.2 (A), J1.A4_B9 (VBUS_A), J1.B4_A9 (VBUS_B)
unnamed: C5.1, D4.1 (K), U1.1 (IN), U1.3 (EN)
unnamed: J1.A5 (CC1), R1.1
unnamed: J1.B5 (CC2), R2.1
unnamed: C3.1, R3.2, R5.2, U2.8 (EN)
unnamed: R4.2, U2.22 (IO8)
unnamed: SW3.1, U2.23 (IO9)
PWM_COOL: J3.2, U2.20 (IO15)
PWM_WARM: J3.1, U2.19 (IO14)
USB_D+: D3.2 (A2), J1.A6 (DP1), J1.B6 (DP2), U2.18 (IO13)
USB_D-: D2.1 (A1), J1.A7 (DN1), J1.B7 (DN2), U2.17 (IO12)

Notes on the sheet:
To POWER_PCB

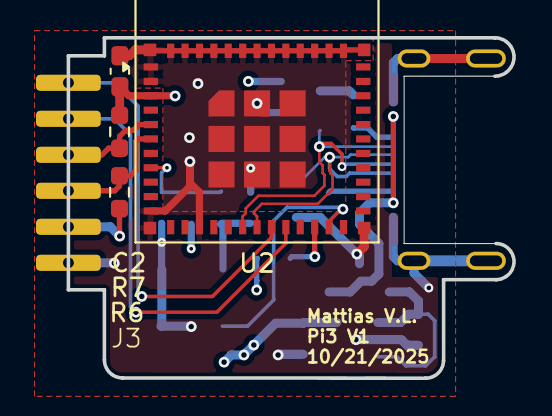
[picture p41: board ESP32_PCB.kicad_pcb from above]

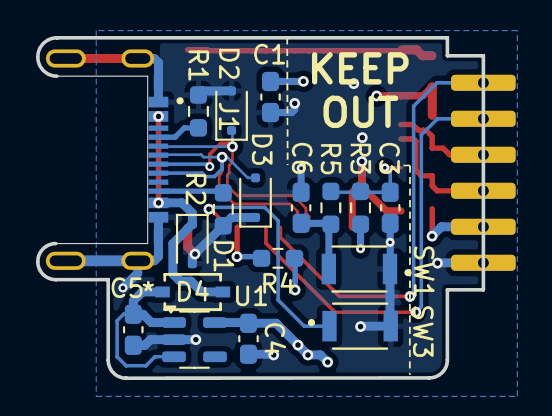
[picture p42: board ESP32_PCB.kicad_pcb from below]

Board: 4 copper layers, 24.8 x 18.9 mm, 23 parts (18 on the bottom side), 16 nets.
