MattiasVLar/AmpouleIntelligente/EDA/3DEL_MCPCB/DEL_MCPCB/DEL_MCPCB.kicad_pcb

## KiCad design EDA/3DEL_MCPCB/DEL_MCPCB/DEL_MCPCB.kicad_pcb (2025-12-03)

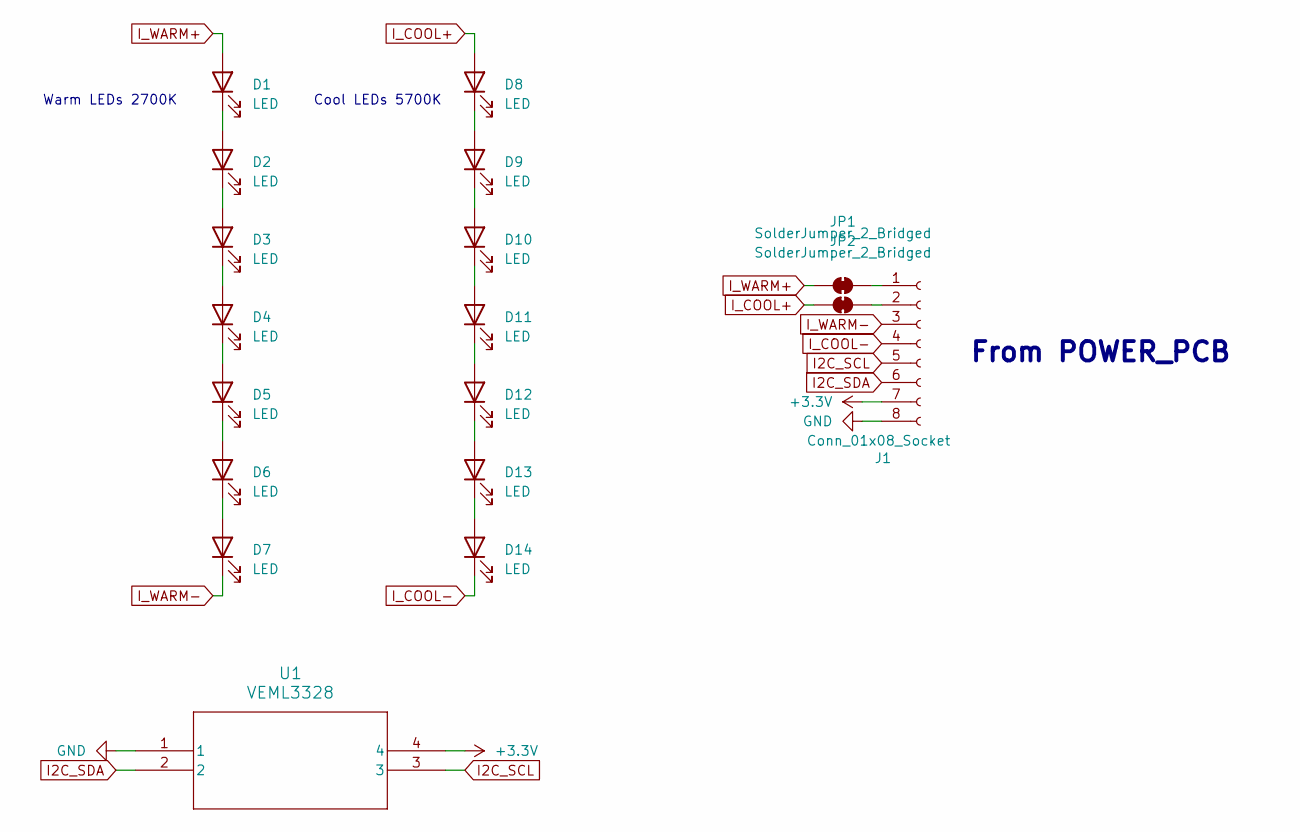
[picture p43: schematic DEL_MCPCB.kicad_sch]

Parts:
D1, D2, D3, D4, D5, D6, D7: LED; LED_Luminus_MP-3030-1100_3.0x3.0mm; Digikey 2138-JK3030AWT-P-U27EA0000-N0000001CT-ND
D8, D9, D10, D11, D12, D13, D14: LED; LED_Luminus_MP-3030-1100_3.0x3.0mm; Digikey 2138-JK3030AWT-P-U57EA0000-N0000001CT-ND
J1: Conn_01x08_Socket; SAMTEC_CLP-104-02-X-D; Digikey SAM1155-04-ND
JP1, JP2: SolderJumper_2_Bridged; R_1206_3216Metric_Pad1.30x1.75mm_HandSolder; Digikey RMCF1206ZT0R00CT-ND
U1: VEML3328; SMD_L3328_VIS; Digikey 751-VEML3328CT-ND

Connections:
+3.3V: J1.7, U1.4
GND: J1.8, U1.1
I2C_SCL: J1.5, U1.3
I2C_SDA: J1.6, U1.2
I_COOL+: D8.2 (A), JP2.1 (A)
I_COOL-: D14.1 (K), J1.4
I_WARM+: D1.2 (A), JP1.1 (A)
I_WARM-: D7.1 (K), J1.3
unnamed: D1.1 (K), D2.2 (A)
unnamed: D2.1 (K), D3.2 (A)
unnamed: D3.1 (K), D4.2 (A)
unnamed: D4.1 (K), D5.2 (A)
unnamed: D5.1 (K), D6.2 (A)
unnamed: D6.1 (K), D7.2 (A)
unnamed: D8.1 (K), D9.2 (A)
unnamed: D9.1 (K), D10.2 (A)
unnamed: D10.1 (K), D11.2 (A)
unnamed: D11.1 (K), D12.2 (A)
unnamed: D12.1 (K), D13.2 (A)
unnamed: D13.1 (K), D14.2 (A)
unnamed: J1.1, JP1.2 (B)
unnamed: J1.2, JP2.2 (B)

Notes on the sheet:
From POWER_PCB
Cool LEDs 5700K
Warm LEDs 2700K

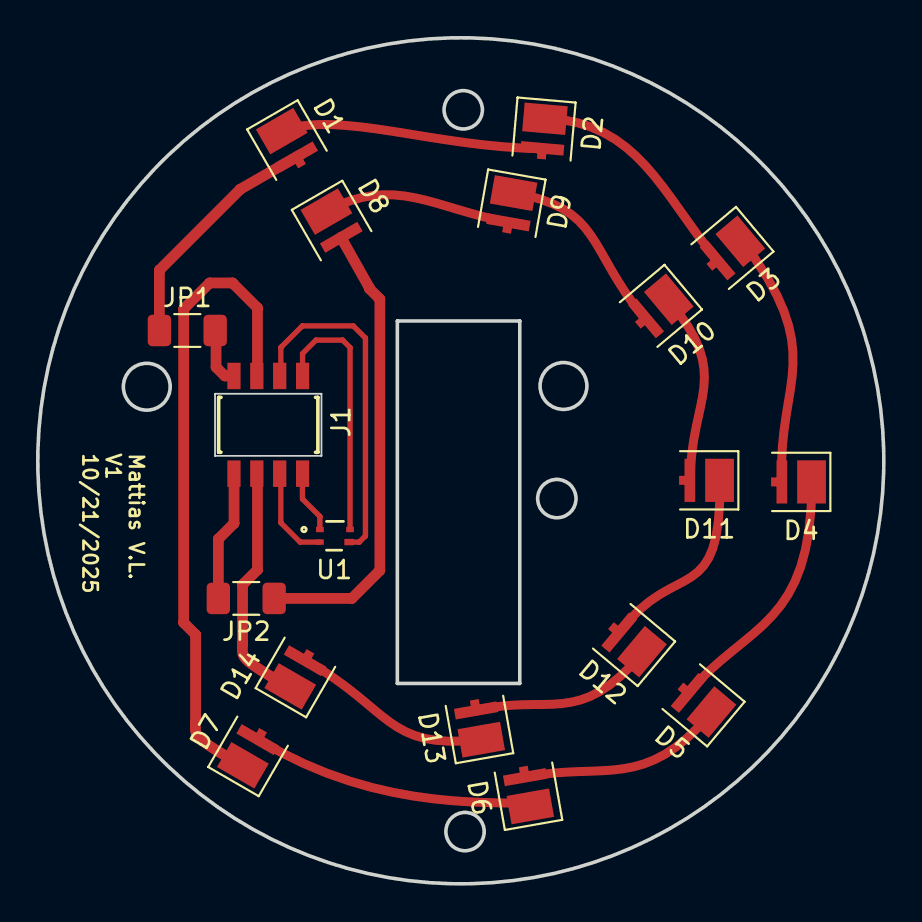
[picture p44: board DEL_MCPCB.kicad_pcb from above]

Board: 2 copper layers, 47.0 x 47.0 mm, 18 parts (0 on the bottom side), 22 nets.
