MattiasVLar/AmpouleIntelligente/EDA/1POWER_PCB/PowerPCB/PowerPCB.kicad_pcb

## KiCad design EDA/1POWER_PCB/PowerPCB/PowerPCB.kicad_pcb (2025-12-03)

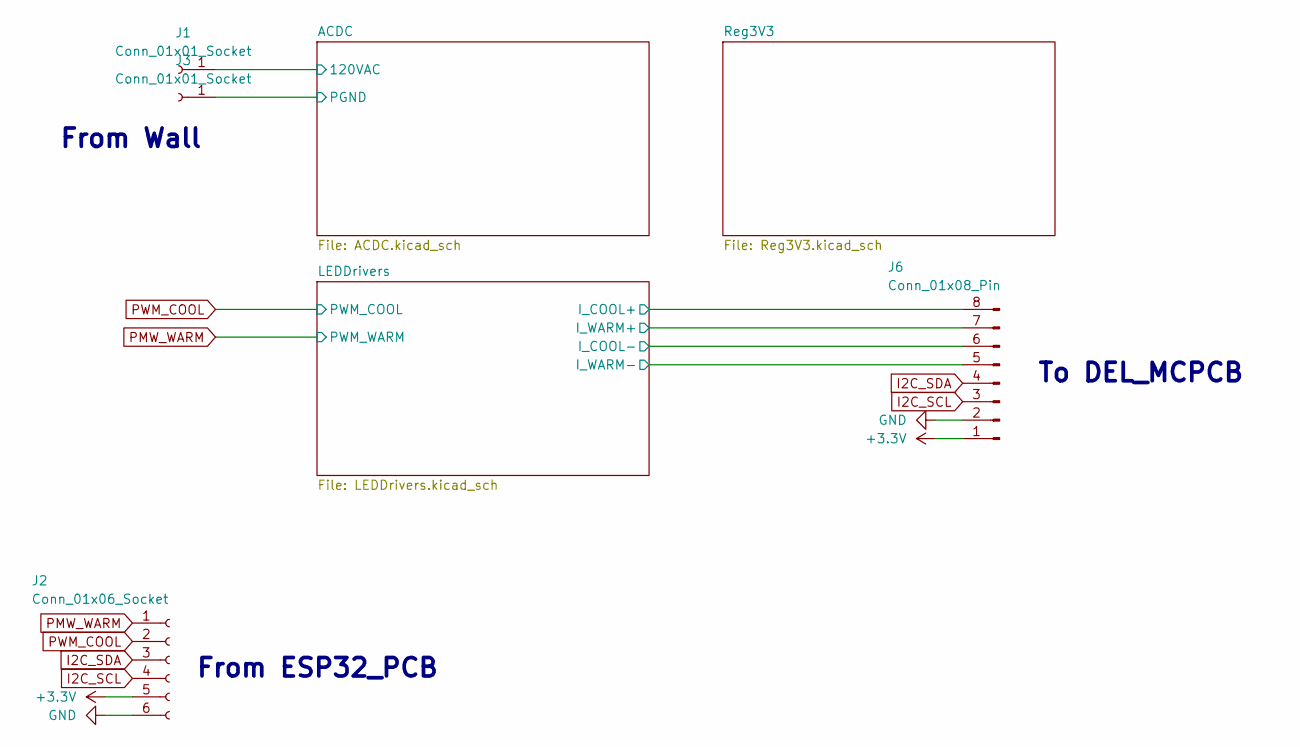
[picture p45: schematic PowerPCB.kicad_sch, POWER_PCB]

Parts:
J1, J3: Conn_01x01_Socket; PADPOWER
J2: Conn_01x06_Socket; EdgeConnHolePi3
J6: Conn_01x08_Pin; SAMTEC_FTSH-104-01-L-DH; Digikey SAM1160-04-ND

Connections:
+3.3V: J2.5, J6.1; also elsewhere on the board
/ACDC/120VAC: J1.1; also elsewhere on the board
/ACDC/PGND: J3.1; also elsewhere on the board
/LEDDrivers/I_COOL+: J6.8; also elsewhere on the board
/LEDDrivers/I_COOL-: J6.6; also elsewhere on the board
/LEDDrivers/I_WARM+: J6.7; also elsewhere on the board
/LEDDrivers/I_WARM-: J6.5; also elsewhere on the board
GND: J2.6, J6.2; also elsewhere on the board
I2C_SCL: J2.4, J6.3
I2C_SDA: J2.3, J6.4
PMW_WARM: J2.1; also elsewhere on the board
PWM_COOL: J2.2; also elsewhere on the board

Notes on the sheet:
From Wall
From ESP32_PCB
To DEL_MCPCB

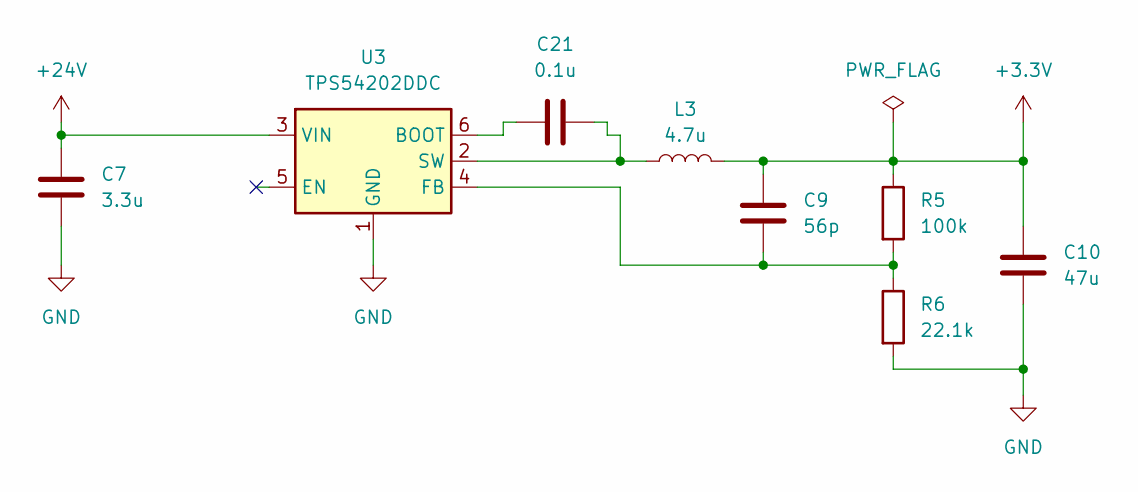
[picture p46: schematic Reg3V3.kicad_sch, POWER_PCB]

Parts:
C7: 3.3u; C_0805_2012Metric_Pad1.18x1.45mm_HandSolder; Digikey 445-5978-1-ND
C9: 56p; C_0805_2012Metric_Pad1.18x1.45mm_HandSolder; Digikey 311-1108-1-ND
C10: 47u; C_0805_2012Metric_Pad1.18x1.45mm_HandSolder; Digikey 587-3266-1-ND
C21: 0.1u; C_0805_2012Metric_Pad1.18x1.45mm_HandSolder; Digikey 399-C0805C104K5RACTUCT-ND
L3: 4.7u; L_Wuerth_MAPI-3020; Digikey 732-74438336047HTCT-ND
R5: 100k; R_0805_2012Metric_Pad1.20x1.40mm_HandSolder; Digikey 311-100KCRCT-ND
R6: 22.1k; R_0805_2012Metric_Pad1.20x1.40mm_HandSolder; Digikey RMCF0805FT22K1CT-ND
U3: TPS54202DDC; SOT-23-6; Digikey 296-TPS54202DDCRCT-ND

Connections:
+3.3V: C9.1, C10.2, L3.2, R5.1; also elsewhere on the board
+24V: C7.1, U3.3 (VIN); also elsewhere on the board
GND: C7.2, C10.1, R6.2, U3.1 (GND); also elsewhere on the board
unnamed: C21.1, U3.6 (BOOT)
unnamed: C9.2, R5.2, R6.1, U3.4 (FB)
unnamed: C21.2, L3.1, U3.2 (SW)

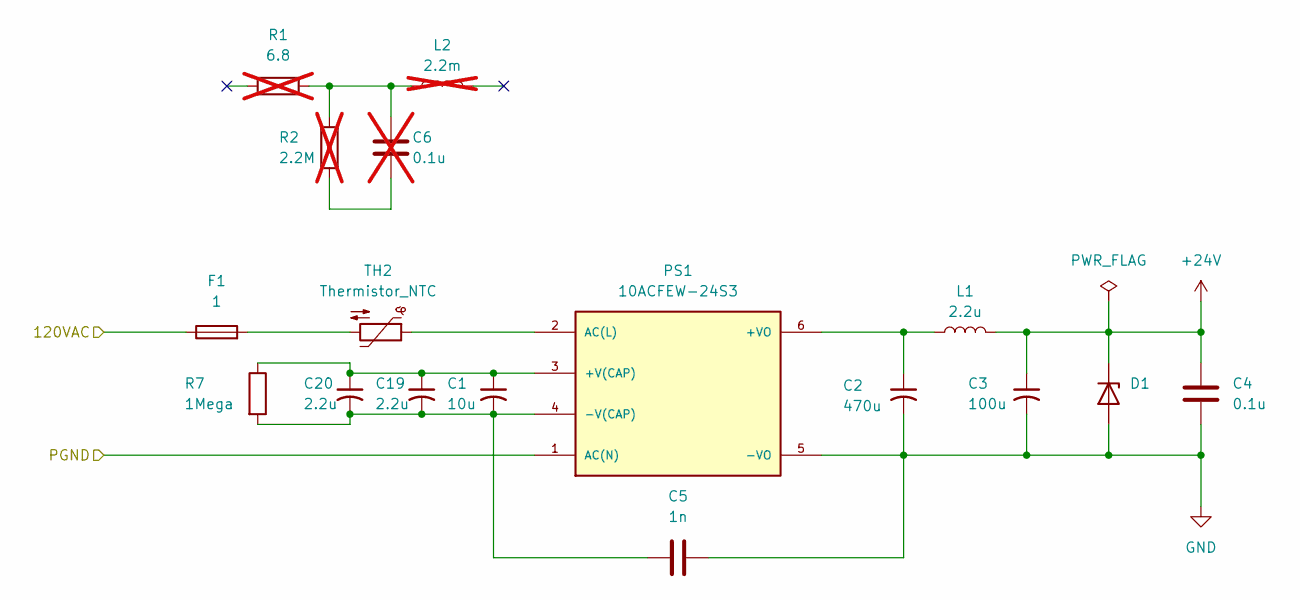
[picture p47: schematic ACDC.kicad_sch, POWER_PCB]

Parts:
C1: 10u; CP_Radial_D10.0mm_P5.00mm; Digikey 493-10416-1-ND
C2: 470u; CAP_UCD_8X10_NCH-L; Digikey 493-14356-1-ND
C3: 100u; CP_Radial_D6.3mm_P2.50mm; Digikey 732-9215-1-ND
C4: 0.1u; C_0805_2012Metric_Pad1.18x1.45mm_HandSolder; Digikey 399-C0805C104K5RACTUCT-ND
C5: 1n; C_Disc_D9.0mm_W5.0mm_P10.00mm; Digikey 490-DE1E3RA102MA4BH01F-ND
C6: 0.1u; R46-AC_KEM; Digikey 399-5862-ND; not fitted
C19, C20: 2.2u; CP_Radial_D6.3mm_P2.50mm; Digikey 1189-400PX2.2MEFC6.3X11-ND
D1: D_SMB; Digikey SMBJ30ALFCT-ND
F1: 1; FUSE_36911000000; Digikey F5459CT-ND
L1: 2.2u; IND_BOURNS_SRN4018; Digikey SRN4018-2R2MCT-ND
L2: 2.2m; IND_BOURNS_SRR1208; Digikey SRR1208-222KLCT-ND; not fitted
PS1: 10ACFEW-24S3; CONV_LS10-13B24R3; Digikey 3182-10ACFEW_24S3-ND
R1: 6.8; RES_NKN3WS_15P5X5_YAG; Digikey 13-NKN3WSJR-73-6R8CT-ND; not fitted
R2: 2.2M; Digikey MFR-25FBF52-2M2-ND; not fitted
R7: 1Mega; R_2010_5025Metric_Pad1.40x2.65mm_HandSolder; Digikey 2019-HV732HTTE1004FCT-ND
TH2: Thermistor_NTC; R_Axial_DIN0207_L6.3mm_D2.5mm_P5.08mm_Vertical; Digikey 317-1158-ND

Connections:
+24V: C3.1, C4.1, D1.1 (K), L1.2; also elsewhere on the board
/ACDC/120VAC: F1.1; also elsewhere on the board
/ACDC/PGND: PS1.1 (AC(N)); also elsewhere on the board
GND: C2.2, C3.2, C4.2, C5.2, D1.2 (A), PS1.5 (-VO); also elsewhere on the board
unnamed: C6.1, R2.2
unnamed: C6.2, L2.1, R1.1, R2.1
unnamed: F1.2, TH2.2
unnamed: C1.1, C19.1, C20.1, PS1.3 (+V(CAP)), R7.1
unnamed: C2.1, L1.1, PS1.6 (+VO)
unnamed: C1.2, C5.1, C19.2, C20.2, PS1.4 (-V(CAP)), R7.2
unnamed: PS1.2 (AC(L)), TH2.1

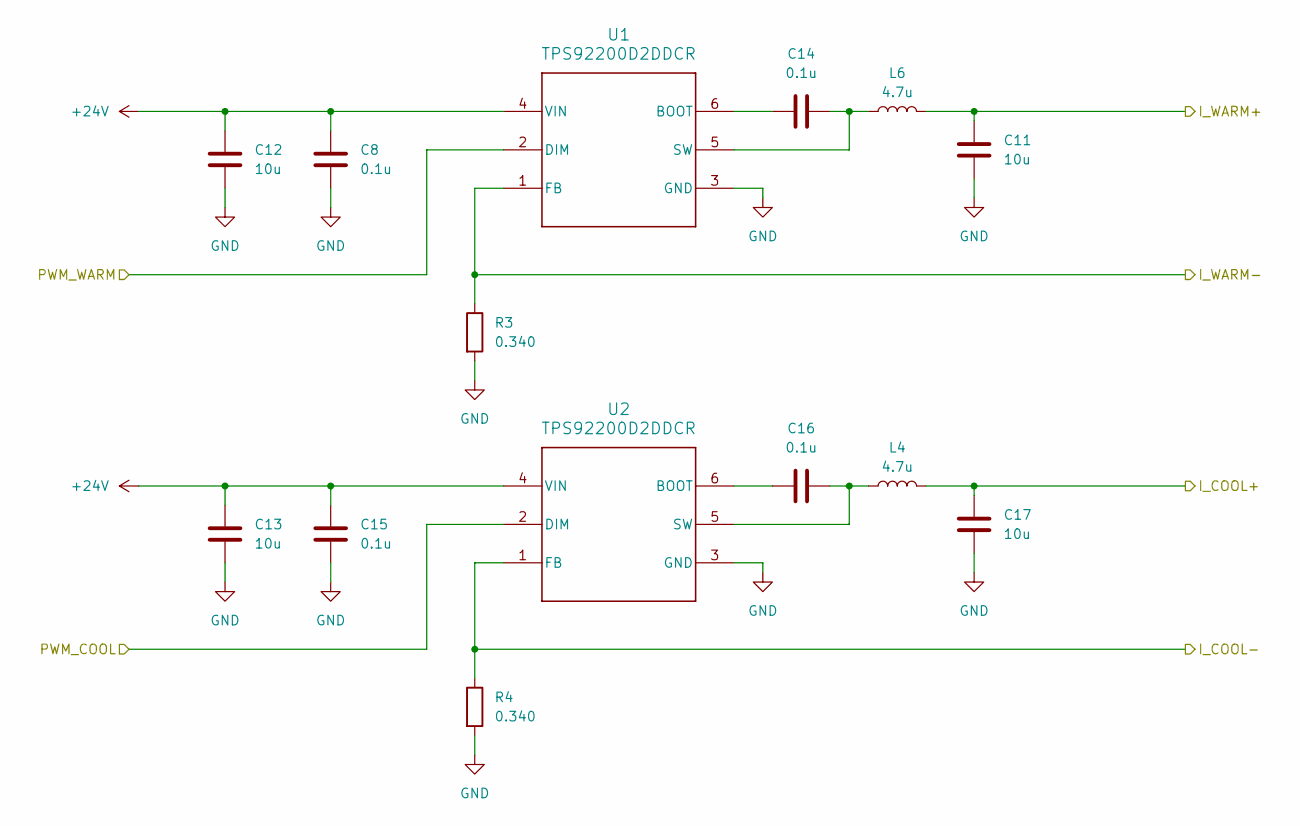
[picture p48: schematic LEDDrivers.kicad_sch, POWER_PCB]

Parts:
C8, C14, C15, C16: 0.1u; C_0805_2012Metric_Pad1.18x1.45mm_HandSolder; Digikey 399-C0805C104K5RACTUCT-ND
C11, C12, C13, C17: 10u; C_0805_2012Metric_Pad1.18x1.45mm_HandSolder; Digikey 490-18663-1-ND
L4, L6: 4.7u; IND_MAMK2520T1R0M_TAY-L; Digikey 587-3228-1-ND
R3, R4: 0.340; R_0805_2012Metric_Pad1.20x1.40mm_HandSolder; Digikey 1712-RLC73K2AR34FTDCT-ND
U1, U2: TPS92200D2DDCR; DDC0006A_L; Digikey 296-TPS92200D2DDCRCT-ND

Connections:
+24V: C8.2, C12.1, C13.1, C15.2, U1.4 (VIN), U2.4 (VIN); also elsewhere on the board
/LEDDrivers/I_COOL+: C17.1, L4.2; also elsewhere on the board
/LEDDrivers/I_COOL-: R4.1, U2.1 (FB); also elsewhere on the board
/LEDDrivers/I_WARM+: C11.1, L6.2; also elsewhere on the board
/LEDDrivers/I_WARM-: R3.1, U1.1 (FB); also elsewhere on the board
GND: C8.1, C11.2, C12.2, C13.2, C15.1, C17.2, R3.2, R4.2, U1.3 (GND), U2.3 (GND); also elsewhere on the board
unnamed: C14.2, U1.6 (BOOT)
unnamed: C14.1, L6.1, U1.5 (SW)
unnamed: C16.2, U2.6 (BOOT)
unnamed: C16.1, L4.1, U2.5 (SW)
PMW_WARM: U1.2 (DIM); also elsewhere on the board
PWM_COOL: U2.2 (DIM); also elsewhere on the board

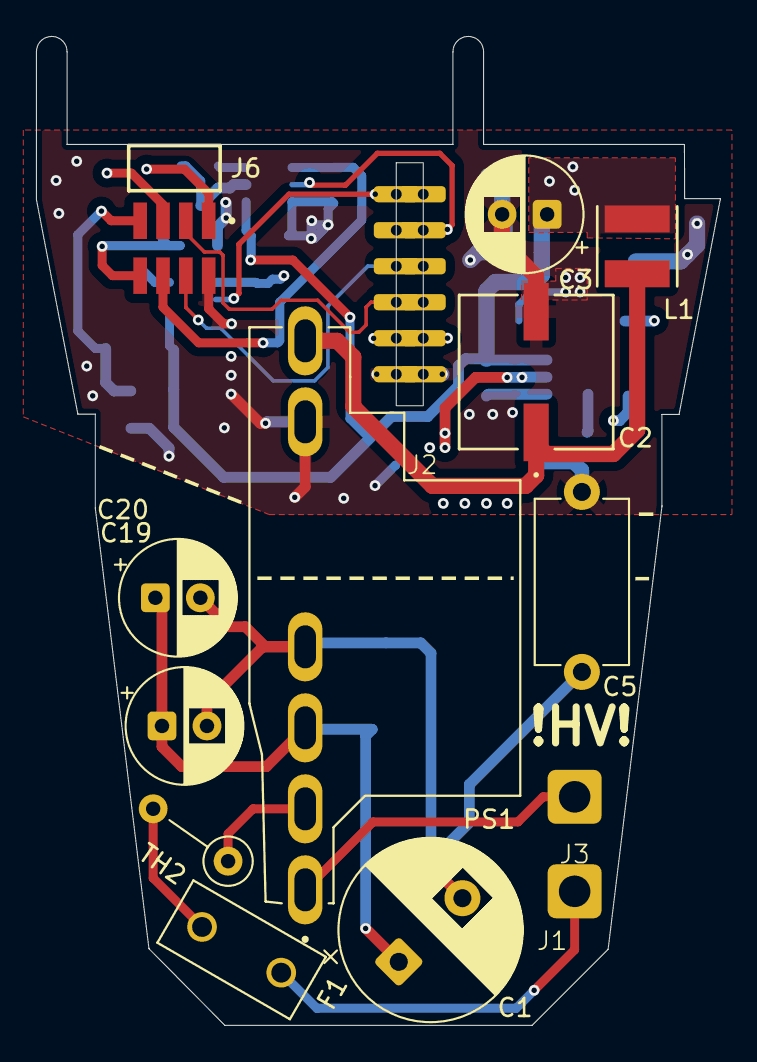
[picture p49: board PowerPCB.kicad_pcb from above]

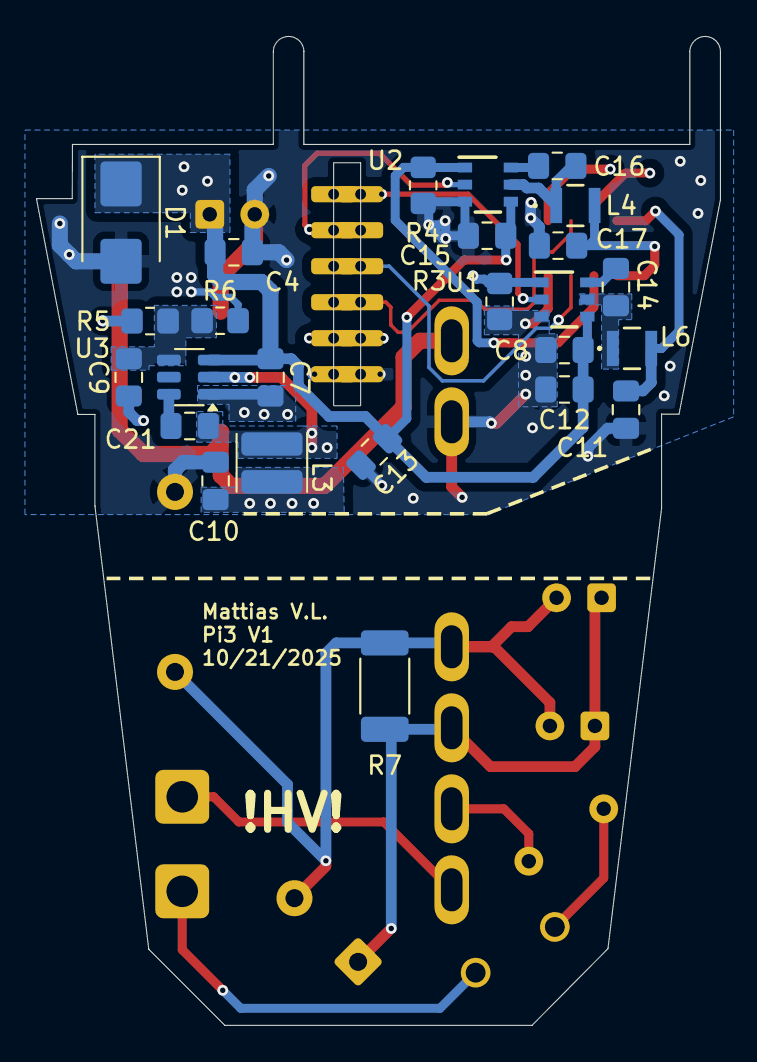
[picture p50: board PowerPCB.kicad_pcb from below]

Board: 4 copper layers, 38.0 x 54.9 mm, 39 parts (25 on the bottom side), 25 nets.
