MattiasVLar/AmpouleIntelligente/(commit log)

2025-12-03 CleanUp EDA
    [1N5819HW-7-F.step, 36911000000.STEP, 36911000000.step, 450BXW15MEFR10X20.step, 6130XX11121_61300211121.step, 80216oplga4l.stp, ACDC.kicad_sch, B3U-1000P.step]
2025-12-07 Changement de commentaires dans CODE
