MattiasVLar/AmpouleIntelligente/(notices)

Notices in the files:
EDA/Includes/Downloads/CLP_104_02_L_D (2)/CLP-104-02-X-D.step:
author */ ('License CC BY-ND 4.0'),
